mustafayildz/EE464-Term-Project-/PCB Output Documentation/3Dview.jpg

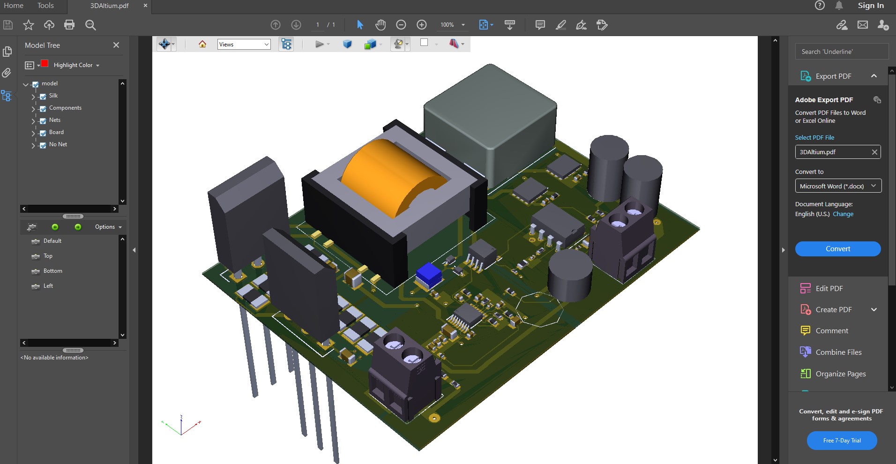
PCB Output Documentation/3Dview.jpg
