mustafayildz/EE464-Term-Project-/README.md

# EE464-Term-Project-
This repository is created by Mustafa Yıldız and Onur Öztaş for the EE464 Course Term Project
