mustafayildz/EE464-Term-Project-/Snubber Design.docx

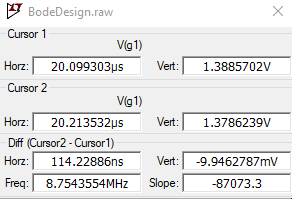
[picture p44: figure]
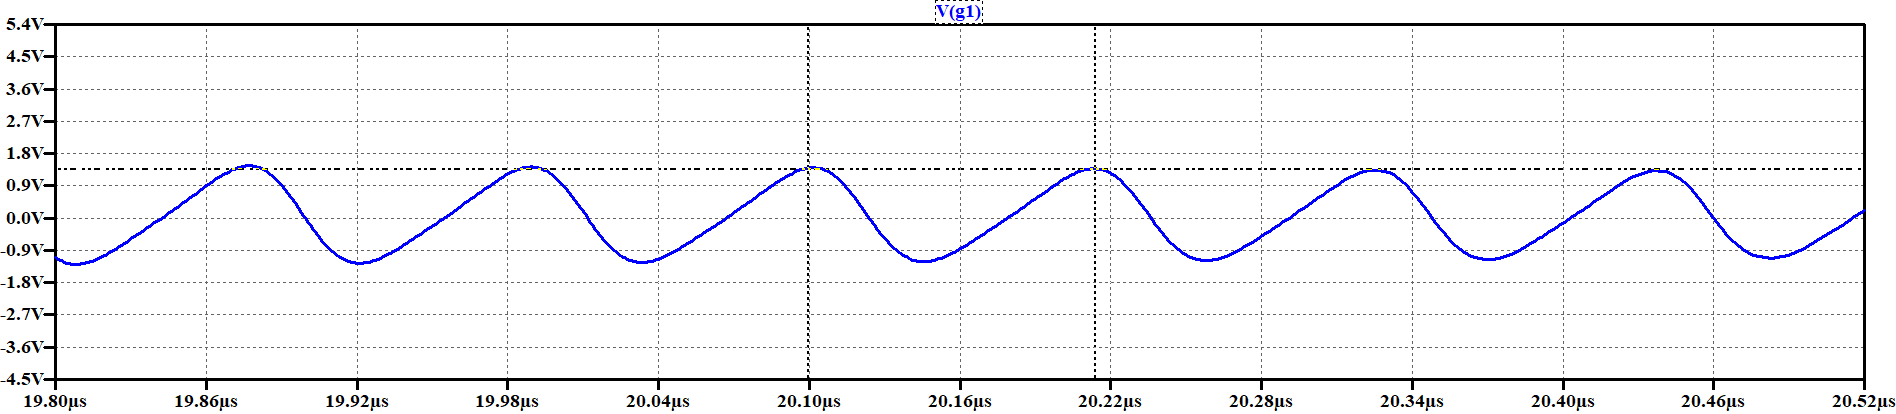
[picture p45: figure]

Resonant frequency is measured as 8.75 MHz Insert parallel capacitor to the MOSFET’s drain to source legs so that that frequency drops half of it. The value of the inserted capacitor is 1100 pF that reduces spike frequency by a factor of two. That capacitance is the three times the value of the parasitic capacitance that created voltage spikes.

C_p =1100/3 pF=367 pF (parasitic capacitance)

By using this value and the resonant frequency measured as above, the value of the parasitic inductance can be found as below.

L=1/((2*π*F_(res) )^2 *C_p)=1/((2*π*8.75*10^6 )^2 *367*10^(-12))=9*10^(-7) H

From these two found values, the characteristics impedance of the resonance can be found as below.

Z=√(L/C)=49.52 Ω

From the calculated impedance and capacitor values, the RC snubber circuits component values can be chosen as;

R≅Z≅49 Ω

4*C_p <C<10*C_p

1468 pF<C<3670 pF

For diode, the same procedure applied to the MOSFET’s can be applied. First resonance frequency of the spike is measured. It is found as 224 MHz Then, by connecting shunt capacitor the value of the parasitic capacitance is found in which the resonance frequency is reduced by a factor of two. Finally, by using the capacitance and resonance frequency values, inductance and reactance values can be found. At the end, almost same of the reactance is selected as snubber resistance, and 200pF capacitance value is selected as the snubber capacitance.

f = 224Mhz

C = 100pF

C_p =100/3 pF=33pF

L=1.53*10^(-8) H

Z=21.53 ohm
