mustafayildz/EE464-Term-Project-/Onur/Magnetic_Design_EER.docx

Transformer Magnetic Design

We set 16 as transformer turns ratio. Maximum input voltage is 400V, input frequency is 100kHz, maximum output current is 8.33A. A core should be selected due to stated specifications. There is no need for energy storing so we decided to use 2 E shape ferrite cores. Firstly, we calculated the area product for required core

W_a A_c =(V_(pri) *I_(pri))/(2*k_(cu) *J_(rms) *B_(ac) *f)

W_a A_c =100/(2*0.6*6*10^6 *0.2*100000)*10^8

W_a A_c =0.0694 cm^4

We checked E shaped ferrite cores and chose 0R42513EC core since it has the smallest area product which is larger than our minimum criteria. Primary and secondary winding turn numbers are calculated as:

N_(pri) >(V_(in))/(4*B_(ac) *A_(core) *f)

N_(pri) >400/(4*0.2*51.8*10^(-6) *100000)

N_(pri) >96.53

N_(pri) =112 Turns

N_(sec) =(N_(pri))/16

N_(sec) =7 Turns

Magnetizing inductance of the transformer is calculated as:

L_m =A_L *N_(pri) ^2

L_m =1900*10^(-9) *128^2

L_m =23.834 mH

RMS values of output and input currents should be calculated in order to make a cable selection.

I_(sec,rms) =√(D*I_(out,ave)^2 +2D*((I_(out,ave))/2)^2)

I_(sec,rms) =√(0.4364*8.333+2*0.4364*8.333^2)

I_(sec,rms) =6.742 A

RMS value of primary side can be found from the turns ratio.

I_(pri,rms) =6.742/16

I_(pri,rms) =0.421 A

Required conductor areas can be found with rms values of the currents and predetermined current density.

A_(pri) =(I_(pri,rms))/(J_(rms))

A_(pri) =0.421/6

A_(pri) = 0.0702 mm^2

A_(sec) =(I_(sec,rms))/(J_(rms))

A_(sec) =6.742/6

A_(sec) = 1.124 mm^2

For secondary side AWG16 satisfies the cross-sectional area but it fails with the frequency, it will work with full skin depth causing large losses. As we include the effect of skin depth, we should use AWG26 according to its maximum frequency for 100% skin depth. AWG26 has a smaller skin depth, so we have to parallel them for the secondary.

N_(parallel,pri) >(A_(pri))/(A_(AWG26))

N_(parallel,pri) >0.0702/0.128

N_(parallel,pri) = 1

N_(parallel,sec) =(A_(sec))/(A_(AWG26))

N_(parallel,sec) >1.124/0.128

N_(parallel,sec) = 10

A_(window) =M*2D

A_(window) =5.35*2*8.7

A_(window) =93.09mm^2

k_(cu) =(2*A_(copper,pri) +2*A_(copper,sec))/(A_(window))

k_(cu) =(2*112*0.128+2*7*10*0.128)/93.09

k_(cu) =50.1%

The design of transformer is completed. Fill factor is satisfactory. Losses of this transformer should be calculated. Copper losses are calculated as follows.

MLT=2п(E-F)/2

MLT=2п(17.5-7.5)/2

MLT=31.416 mm

R_(pri) =(N_p *MLT*R)/(Number of parallel cables)

R_(pri) =(112*31.416*133.8568*10^(-6))/1

R_(pri) =471 mΩ

R_(sec) =(N_p *MLT*R)/(Number of parallel cables)

R_(sec) =(7*31.416*133.8568*10^(-6))/10

R_(pri) =2.944 mΩ

P_(cu,total) =2*P_(cu,pri) +2*P_(cu,sec)

P_(cu,total) =2*0.421^2 *471*10^(-3) +2*8.333^2 *2.994*10^(-3)

P_(cu,total) =0.58W

Core loss is calculated as follows.

P_(core) =a*f^x *B^y *V_(core)

P_(core) =0.036*100^1.64 *0.2^2.68 *(2*2.99)

P_(core) =2.63 W

P_(transformer) =0.58+2.63

P_(transformer) =3.21 W

The related skin depth analysis for this application can be conducted as:

Skin Depth(δ)=√(ρ/(π*f_o *μ_r *μ_0))

δ=√(0.0171/(π*100*10^3 *0.999994*4*π*10^(-7)))

δ=208μm

In this design only AWG26 cable is used. Diameter of this cable is 0.403mm. Therefore, the skin depth exist which is 0.208mm will not create a problem for this design.

Inductor Magnetic Design

An output inductor is needed with capability of handling 8.33A and being larger than 160μH. We checked the cores from the smallest one in order to reduce costs and achieved our criterion at 0W41305TC. Calculations are as follows:

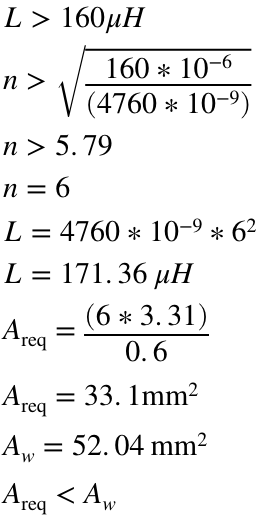
[picture p46: figure]
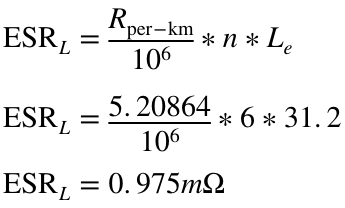
[picture p47: figure]
