mustafayildz/EE464-Term-Project-/EE464_Proje_Sunu.pptx

## EE 464 Term Project DC-DC Converter Design

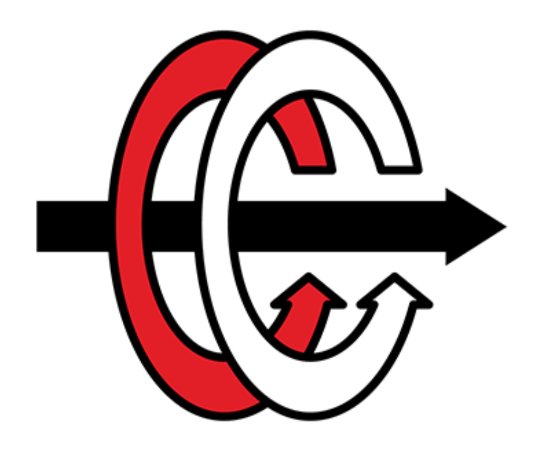
[picture p50: figure]
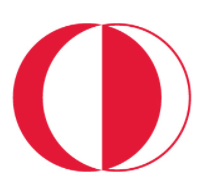
[picture p51: figure]
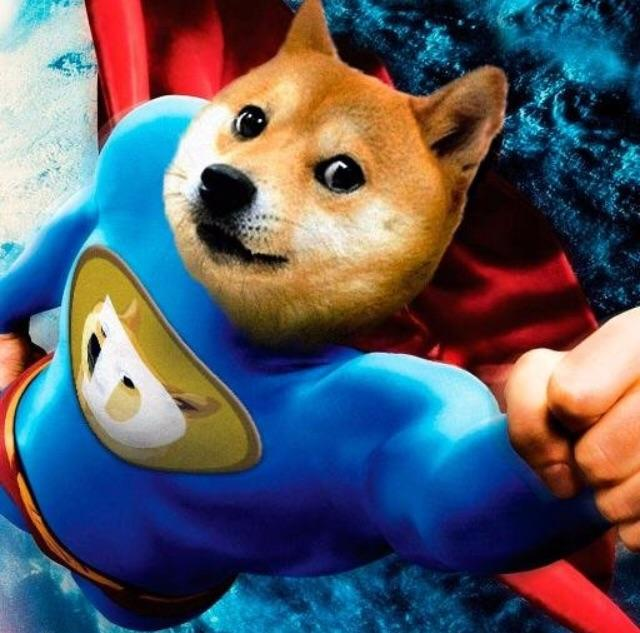
[picture p52: figure]
Doge power 🚀🌚🐕 : dogecoin

Doge Power Inc.
Onur Öztaş 2330389
Mustafa Yıldız 2233013

## Project Specifications

DC/DC
Converter

- 12V DC output voltage
- Isolated signal
- 100W output power
- Less than 4% voltage ripple
- Less than 3% line regulation
- Less than 3% load regulation

220V-400V DC Voltage

## Topology Selection

- Flyback
- Forward
- Half Bridge
- Full Bridge
- Push – Pull

## Topology Selection

- Flyback
Advantages:
- Less component requirement, no output inductance
Disadvantages:
- Big output capacitor requirement
- Narrow closed loop bandwidth

## Topology Selection

- Forward
Advantages:
- One switching element
Disadvantages:
- Transformer utilization factor is not sufficient

## Topology Selection

- Half Bridge
- Full Bridge

## Topology Selection

- Push Pull
Advantages:
- Better transformer utilization
  - Core size is small compared to others
  - Transformer ratings are smaller
- Small output filter requirement
Disadvantages:
- Center Tap Transformer configuration

## Analytical Calculations

V_o =V_(in) ∗2∗(N_2)/(N_1)∗D_(min)
12=400∗2∗1/16∗D_(min)
D_(min) =0.24
12=400∗2∗1/16∗D_(max)
D_(max) =0.4364

0.6/2=0.3
(220+400)/2=310
V_o =V_(in) ∗2∗(N_2)/(N_1)∗D
12=310∗2∗(N_2)/(N_1)∗0.3
(N_2)/(N_1)=1/16

- Calculation of Turns Ratio

- Limit Values of Duty Cycle

## Analytical Calculations

- Calculation of main parameters

(ΔV_o)/(V_o)=((1−2∗D)(1/(f_s))^2)/(8∗L∗C)
D=0.4364 (Worst Case)
0.04>((1−2∗0.4364)(1/(2∗f_s))^2)/(8∗L∗C)
L∗C∗f_s ^2 >0.09943

- f=100kHz

L∗C>0.09943/((10∗10^3 )^2)
L∗C>9.943∗10^(−12)

L=160μH

C>(9.943∗10^(−12))/(160∗10^(−6))
C>62.15 nF

## Output Filter Design

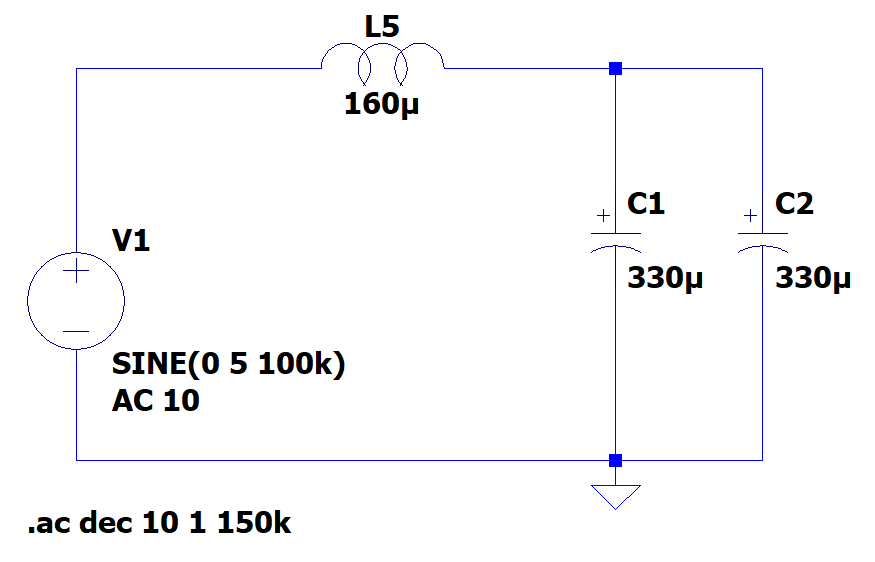
[picture p53: figure]
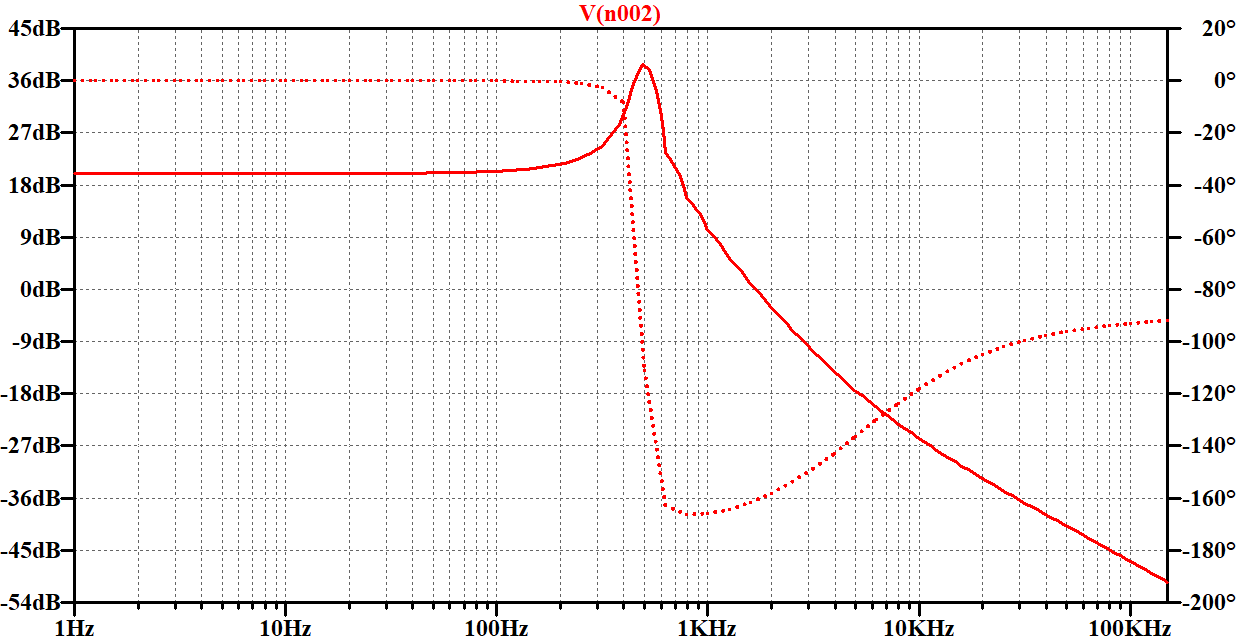
[picture p54: figure]

## Analytical Calculations

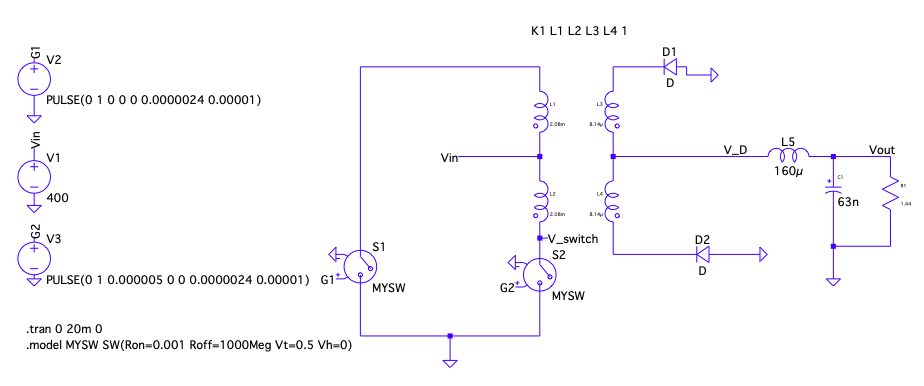
[picture p55: figure]

## Analytical Calculations

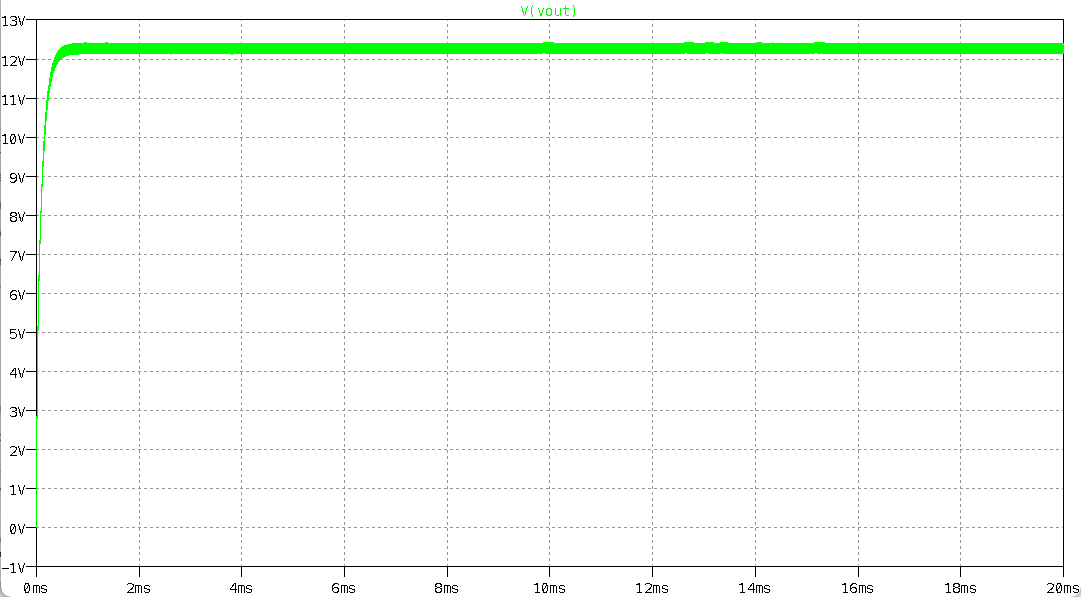
[picture p56: figure]
tablo içeren bir resim Açıklama otomatik olarak oluşturuldu

## Analytical Calculations

- Current Rating of Diodes
  - 9 A (forward)
- Voltage Rating of Switches
  - 800 V (blocking)
- Current Rating of Switches
  - 800 mA

- Current Rating of Output Inductor
  - 8.333 A
- Voltage Rating of Output Capacitor
  - 12 V
- Voltage Rating of Diodes
  - 50 V (blocking)

## Controller Design

LTC3723 Current Mode Controller

LT1431 Programmable Reference
(Opto – Driver )

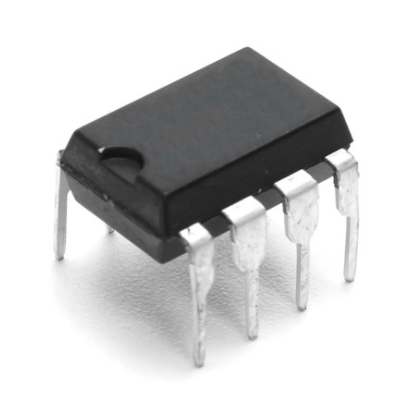
[picture p57: figure]
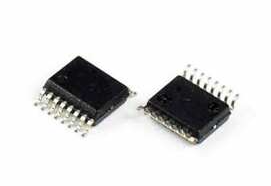
[picture p58: figure]
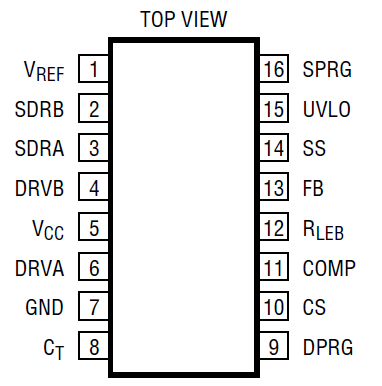
[picture p59: figure]
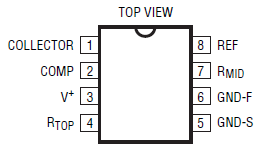
[picture p60: figure]

## Controller Compensator Design

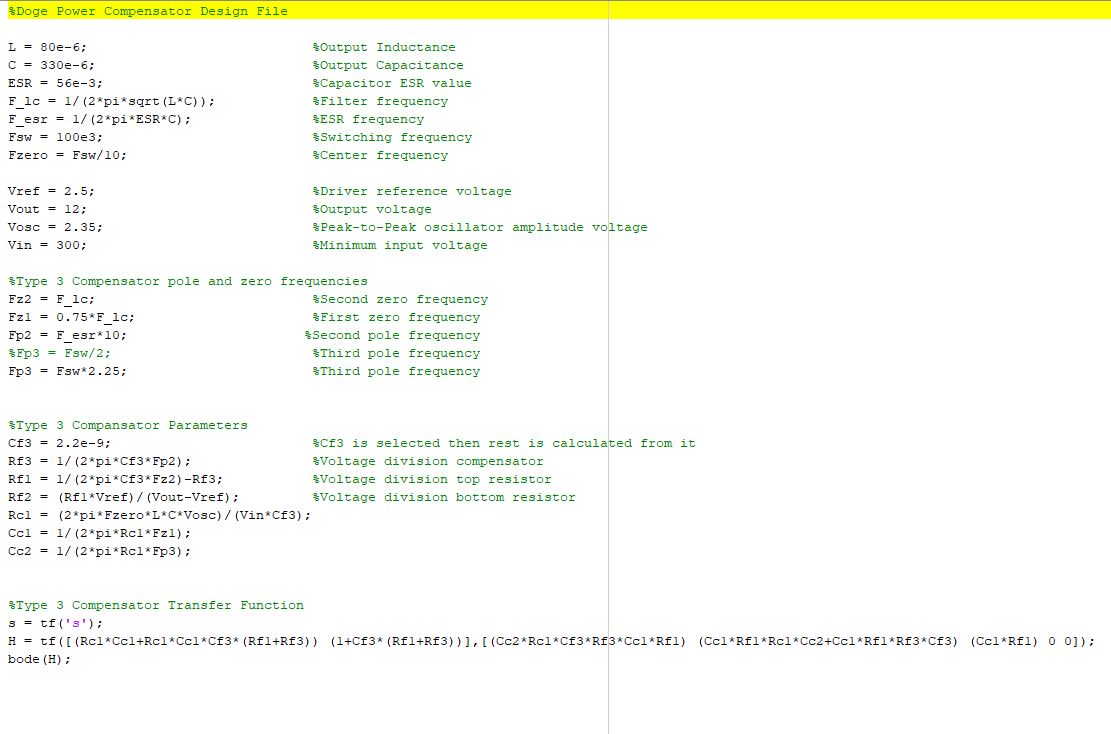
[picture p61: figure]

## Controller Compensator Design

## Controller Compensator Design

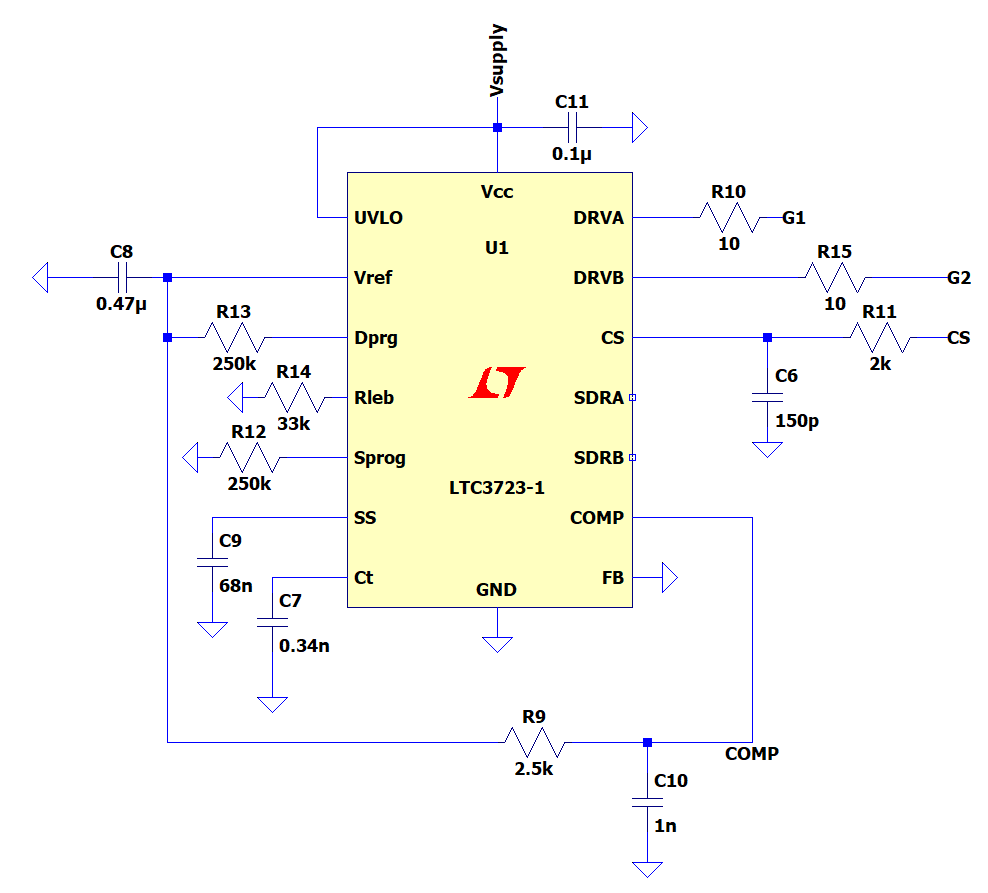
[picture p62: figure]

## Controller Compensator Design

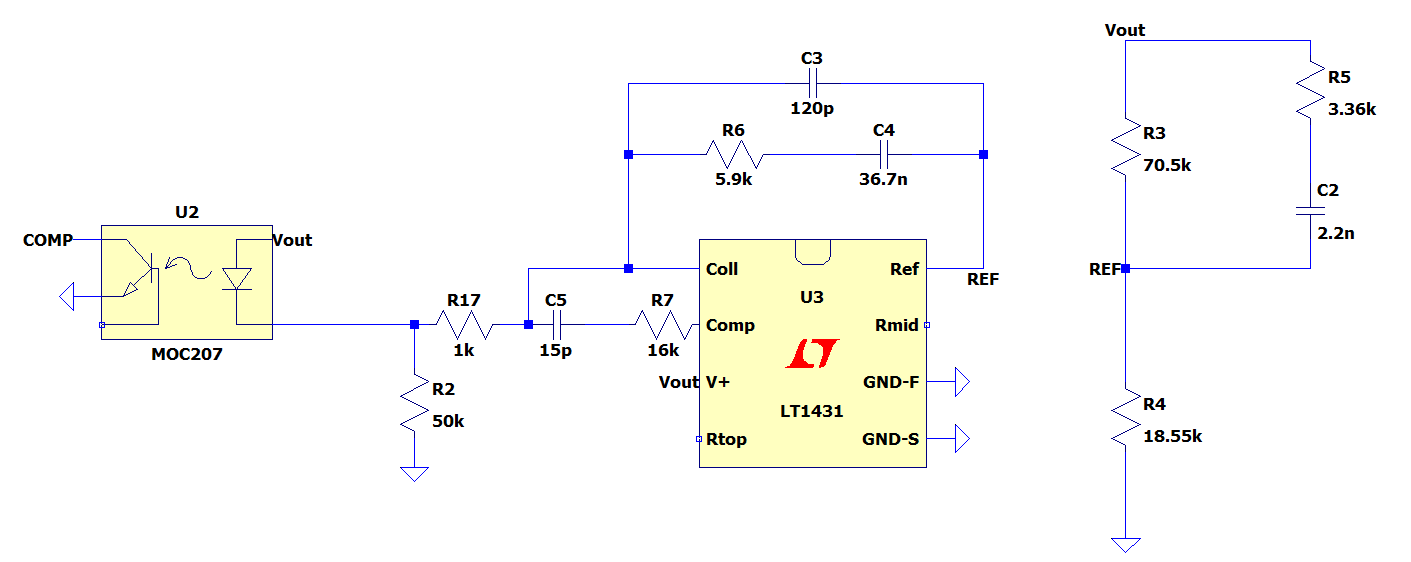
[picture p63: figure]

## Snubber Design


- Oscillation frequency : 8.75 MHz
  - C = 1100pF ; C_p =C/3 → L=1/((2∗π∗f_(osc) )^2 ∗C_p) →Z=√(L/C)
- R≅Z
- 4∗C_p <C<10∗C_p

## Snubber Design

## Simulation Results

- 220V input voltage

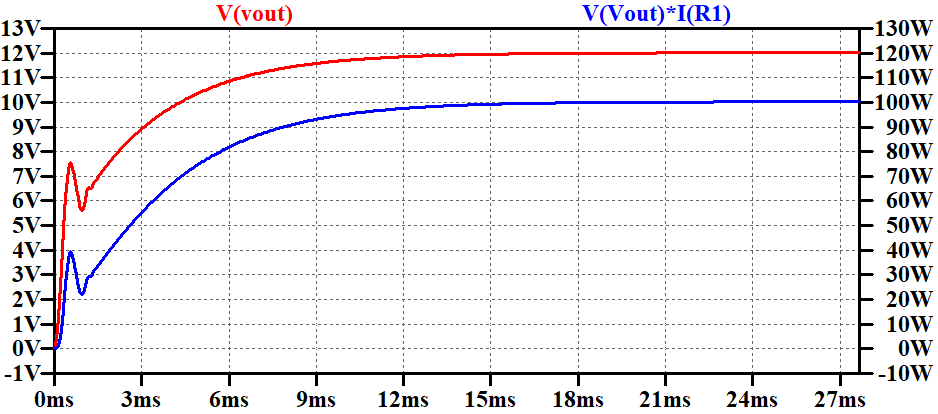
[picture p64: figure]

## Simulation Results

- 220V input voltage – output voltage ripple

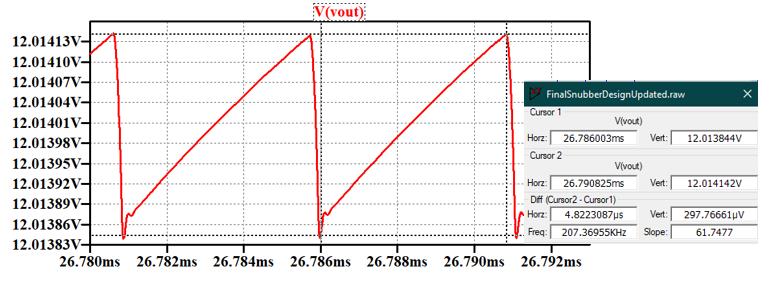
[picture p65: figure]

## Simulation Results

- 220V input, No load to Full Load


## Simulation Results

- 400V input voltage

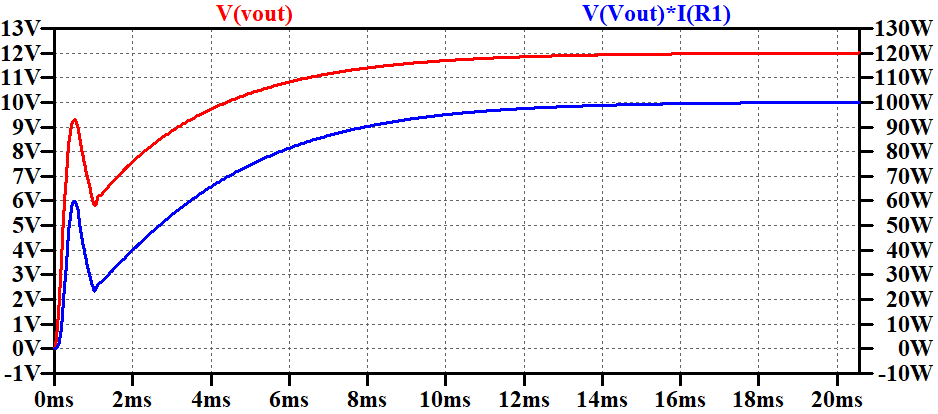
[picture p66: figure]

## Simulation Results

- 400V input voltage – output voltage ripple

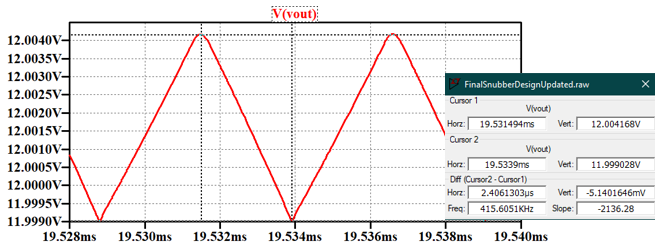
[picture p67: figure]

## Simulation Results

- 400V input, No load to Full Load

tablo içeren bir resim Açıklama otomatik olarak oluşturuldu

## Magnetic Design of Transformer

n_1 >(V_(i,max) ∗D_(max) ∗1/(f_s))/(B_(sat) ∗A_e)
n_1 >(400∗0.4364∗1/(100∗10^(−3)))/(0.53∗0.77∗10^(−6))
n_i >42.76
n_1 =48 Turns
n_2 =48/16
n_2 =3 Turns

- Minimum turns for not saturating the core

- Other Specifications

- Input Current
  - 0.25A at 100kHz
  - AWG 25 (due to frequency)
- Output Current
  - 9A DC
  - AWG 12 (due to current)
- 2 EER cores
  - PC47EER28-Z

## Magnetic Design of Transformer – Magnetising Inductance

µ=µ_0 ∗µ_r
µ=2500∗4∗π∗10^(−7)
µ=0.003142
R=((14+9.65)/2∗10^(−3) ∗2)/(µ∗(9.9/2)^2 ∗π)∗(((21.2+3.4)/2∗10^(−3) ∗2)/(µ∗4.35∗10^(−3) ∗11.4∗10^(−3))+((14+9.65)/2∗10^(−3) ∗2)/(µ∗3.4∗10^(−3) ∗11.4∗10^(−3)))/2
R=443821
L_m =(N^2)/R
L_m =(48^2)/443821
L_m =5.19 mH

## Magnetic Design of Transformer - Skin Depth

Skin Depth(δ)=√(ρ/(π∗f_o ∗μ_r ∗μ_0))
Skin Depth(δ)=√((1.678∗10^(−6))/(π∗100∗10^3 ∗0.999995∗4∗π∗10^(−7)))
Skin Depth(δ)= 206μm
AWG12 : 2.05mm diameter
AWG25 : 0.455mm diameter

## Magnetic Design of Inductor

L>160 µH
n>√((160∗10^(−6))/(4760∗10^(−9)))
n>5.79
n=6
L=4760∗10^(−9) ∗6^2
L=171.36 µH

- Selected Core: 0W41305TC

- ESR Value

ESR_L =(R_(per−km))/(10^6)∗n∗l_e
ESR_L =5.20864/(10^6)∗6∗(π∗5.08)
ESR_L =0.499mΩ

Filling Ratio = 0.6

A_(req) =(6∗3.31)/0.6
A_(req) =33.1 mm^2
A_w =52.04 mm^2

## Component Selection

- Key parts are:
  - Controllers
  - MOSFETs
  - Diodes
  - Thermal Analysis and Heatsink

## Component Selection

- MOSFET

- Drain-Source Resistance
  - 350m Ω
- Transient time
  - Rise time: 16 ns
  - Fall time: 17 ns
- Gate Charge
  - 19 nC

- Diodes

- Forward voltage
  - 0.56 V

## Component Selection - Controllers

- LTC3723-1

- Controller + Gate Driver
- Non-isolated – Required external isolation
- Dead-Time control
- Frequency control
- Soft start property
- 2 gate synchronous drive capability

- LT1431

- Opto-coupler driver
- Internal compensator design property

## Loss Calculations

MOSFETs (Calculated for One):
P_(conduction) =I^2 ∗D∗R_(DS)
P_(conduction) =7^2 ∗0.12∗0.35
P_(conduction) =2.058 W
P_(switching) =1/2∗V_(in) ∗I_(in) ∗(t_r +t_f )∗f
P_(switching) =1/2∗400∗7∗(16+17)∗10^(−9) ∗100∗10^3
P_(switching) =4.62 W
P_(gate) =V_(GS) ∗f∗Q_g
P_(gate) =20∗100∗10^3 ∗19∗10^(−9)
P_(gate) =0.038 W

## Loss Calculations

Transformer:
P_(core) =1.72 W
Diodes (Calculated for One):
P_(loss) =0.6∗I_(f(AV)) +0.00367∗I_(f(rms))^2
P_(loss) =0.6∗4.165 +0.00367∗5.592^2
P_(loss) =2.613 W
Output Inductor:
P_(loss) =I_o^2 ∗ESR
P_(loss) =8.333^2 ∗0.499∗10^(−3)
P_(loss) =0.035 W
Integrated Circuits:
P_(total) =0.42 W

## Thermal Analysis - MOSFET

P_(loss,MOSFET) =6.716 W

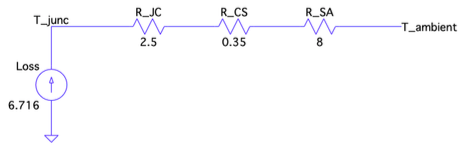
[picture p68: figure]

T_(junction) =(8+0.35+2.5)∗6.716+25
T_(junction) =97.87^o C
