mustafayildz/EE464-Term-Project-/Mustafa/Closed Loop Design/400Vin_Output_Voltage_Ripple.png

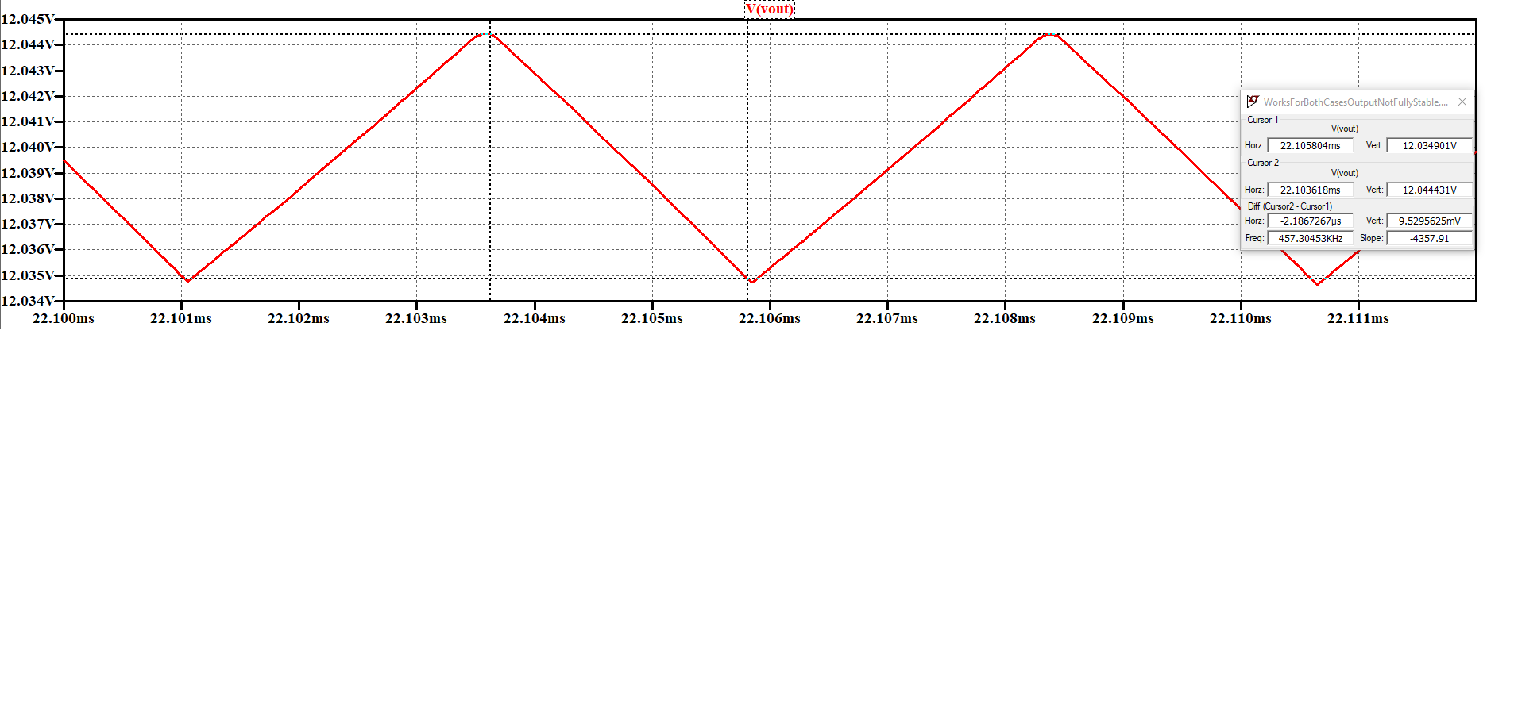
Mustafa/Closed Loop Design/400Vin_Output_Voltage_Ripple.png
