mustafayildz/EE464-Term-Project-/Mustafa/Closed Loop Design/NoLoad_to_Full_Load_220V.png

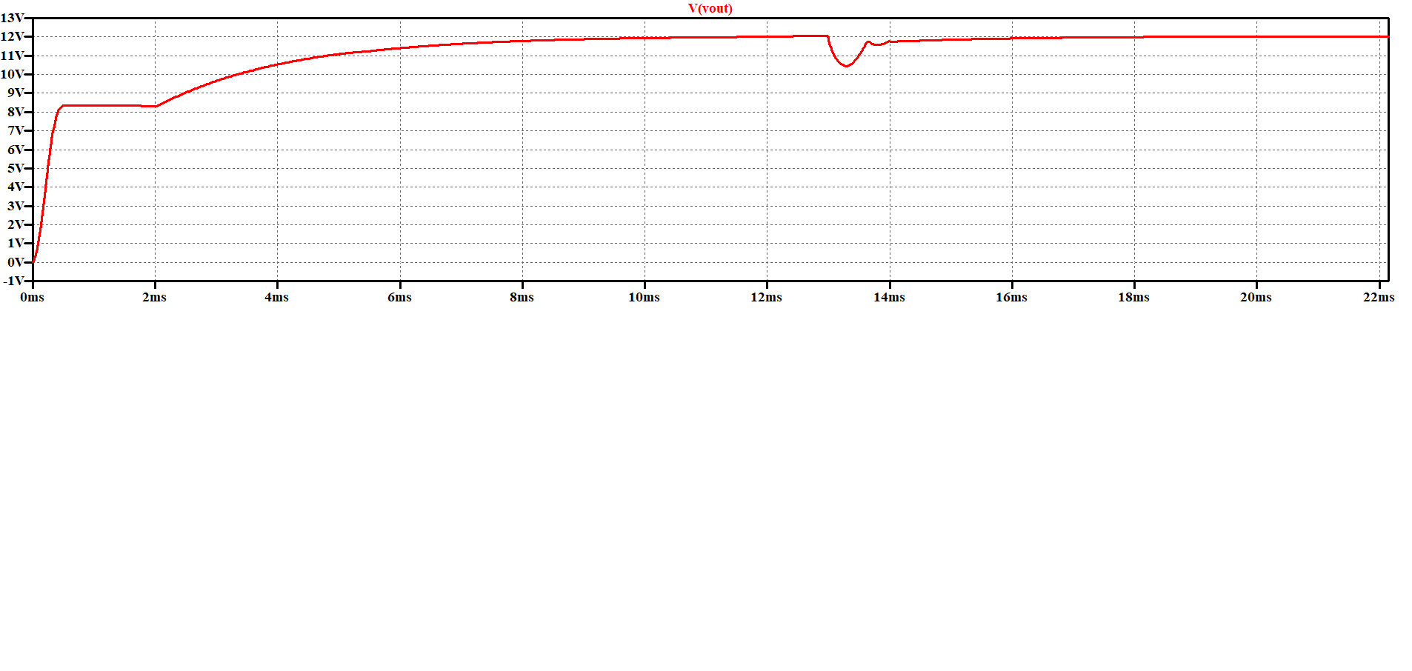
Mustafa/Closed Loop Design/NoLoad_to_Full_Load_220V.png
