mustafayildz/EE464-Term-Project-/Mustafa/Closed Loop Design/NoLoad_to_Full_Load_400V.png

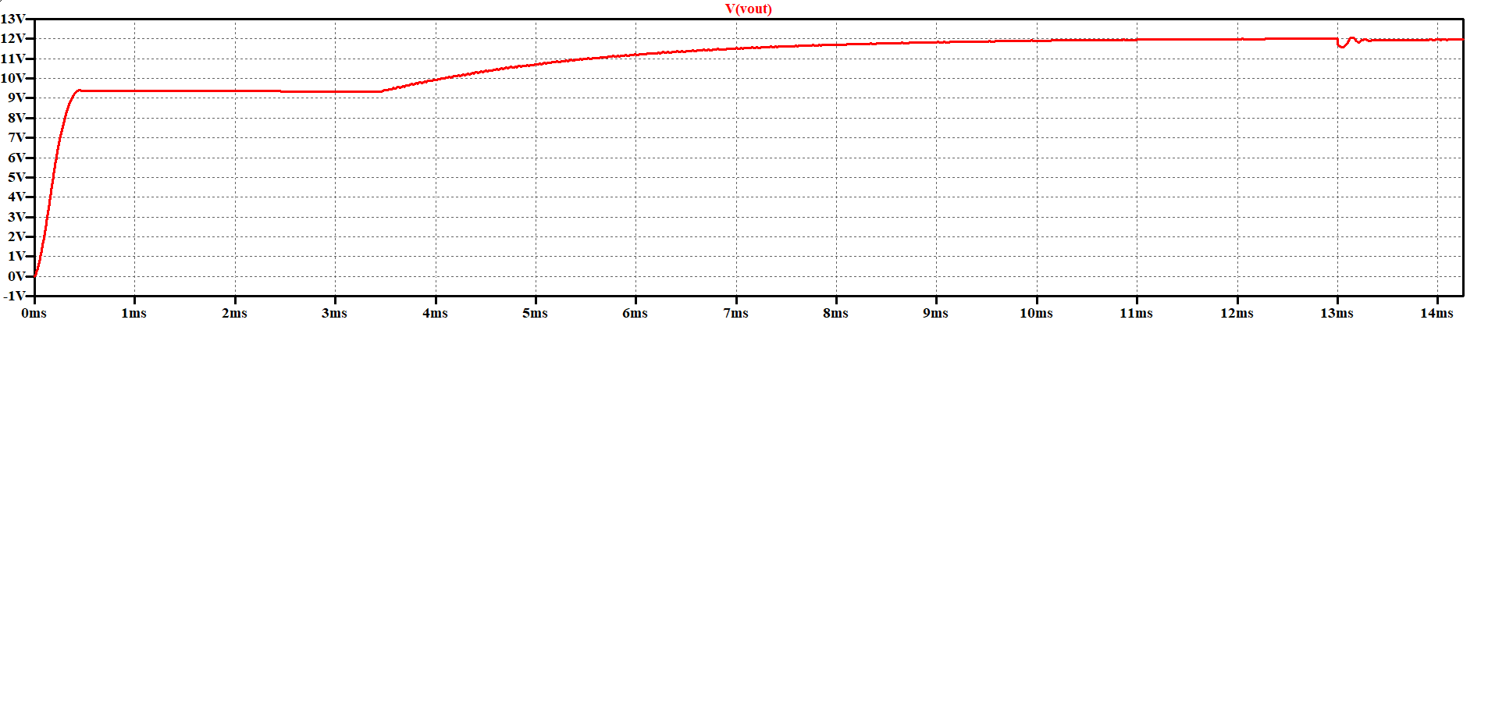
Mustafa/Closed Loop Design/NoLoad_to_Full_Load_400V.png
