mustafayildz/EE464-Term-Project-/Onur/BOM.xlsx

Component | Serial Number | Price($) (unit price for purchase of 1000) | ESR | ESL | Vf
Controller | LTC3723EGN-1#PBF | 6.48
C8 | MA0805XR474K500 | 0.0095
C9 | GMC04X5R683K16NT | 0.0038
C7 | MA0402XR331K500 | 0.00262
C10 | GMC02X7R102M16NT | 0.0019
C6 | GMC04X7R151K16NT | 0.0032
C1 | 337CKS025M | 0.10051 | 0.703 Ohm
C2 | GMC04X7R222K50NT | 0.0028
C3 | GMC04CG120J25NT | 0.0018
C4 | GMC04X7R393K25NT | 0.0048
C5 | GMC04CG150J50NT | 0.0019
C12 | GMC21CG201J100NT | 0.027
C13 | GMC21CG201J100NT | 0.027
C14 | 90150 | 0.1532
C16 | 90150 | 0.1532
C17 | 337CKS025M | 0.10051 | 0.703 Ohm
Transformer Core | PC47EER28L-Z | 0.9576
D1 | STPS30H100DJF-TR | 0.4914 |  |  | 0.56
D2 | STPS30H100DJF-TR | 0.4914 |  |  | 0.56
Optoisolator | MOC207M | 0.25
Voltage Reference | LT1431CS8#TRPBF | 2.58
C11 | MC04X5R104K25NT | 0.0045
Output Inductor Core | 0W41305TC | 2
M1 | C3M0350120D | 3.5
M2 | C3M0350120D | 3.5
Heatsink 1 | 513301B02500G | 0.83992
Heatsink 2 | 513301B02500G | 0.83992
Thermal Pad | Q3-0.005-00-114 | 0.05
Thermal Pad | Q3-0.005-00-114 | 0.05
Total |  | 22.62848
