mustafayildz/EE464-Term-Project-/PCB Output Documentation/PCB_Project_1.xlsx

Comment | Description | Designator | Quantity | Mouser2 Price/Stock | Mouser Price/Stock
C0603C151G1GACTU | Capacitor | 2C150p | 1 |  | https://www.mouser.co.uk/ProductDetail/KEMET/C0603C151G1GACTU?qs=tVefkKa6a1jhbIoxyvPmcA%3D%3D
06031C104K4Z2A | Capacitor | C0.1u | 1 |  | https://www.mouser.co.uk/ProductDetail/AVX/06031C104K4Z2A?qs=rI7uf1IzohSnOGTrilMFWw%3D%3D
04025C102JAT2A | Capacitor | C1n | 1 |  | https://www.mouser.co.uk/ProductDetail/AVX/04025C102JAT2A?qs=A%252BjgVRj0cIhSqwAr58%2FhLg%3D%3D
C1608X5R1H105K080AB | Capacitor | C1u | 1 |  | https://www.mouser.co.uk/ProductDetail/TDK/C1608X5R1H105K080AB?qs=NRhsANhppD%252BLmxnPDqAv3A%3D%3D
CL31A106MBHNNNE | Capacitor | C10u | 1 |  | https://www.mouser.co.uk/ProductDetail/Samsung-Electro-Mechanics/CL31A106MBHNNNE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
06035A220JAT2A | Capacitor | C22p | 1 |  | https://www.mouser.co.uk/ProductDetail/AVX/06035A220JAT2A?qs=WmCxkUxNecRe2%252BrYSa2zPg%3D%3D
885012206070 | Capacitor | C68n | 1 |  | https://www.mouser.co.uk/ProductDetail/Wurth-Elektronik/885012206070?qs=0KOYDY2FL2%252BdYxnLFqlX4w%3D%3D
CL10C151JB8NNNC | Capacitor | C150p | 1 |  | https://www.mouser.co.uk/ProductDetail/Samsung-Electro-Mechanics/CL10C151JB8NNNC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
1206B471K102CT | Capacitor | C470p, C2470p | 2 |  | https://www.mouser.com/Search/Refine.aspx?Keyword=791-1206B471K102CT
CGA4J1X8L1H474K125AE | Capacitor | C.47u | 1 |  | https://www.mouser.co.uk/ProductDetail/TDK/CGA4J1X8L1H474K125AE?qs=zW32dvEIR3uIPrP%252BfC4jsA%3D%3D
CL10A226MP8NUNE | Capacitor | Caux | 1 |  | https://www.mouser.co.uk/ProductDetail/Samsung-Electro-Mechanics/CL10A226MP8NUNE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
GRM3195C2A363JA01D | Capacitor | Cbot | 1 |  | https://www.mouser.co.uk/ProductDetail/Murata-Electronics/GRM3195C2A363JA01D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
GRM21B5C2J222FWAAL | Capacitor | Ccomp | 1 |  | https://www.mouser.co.uk/ProductDetail/Murata-Electronics/GRM21B5C2J222FWAAL?qs=hd1VzrDQEGgwnUkpelVx4g%3D%3D
GCQ1555C1H150FB01D | Capacitor | Cmid | 1 |  | https://www.mouser.co.uk/ProductDetail/Murata-Electronics/GCQ1555C1H150FB01D?qs=0lQeLiL1qybEKEeEBMn8jw%3D%3D
ECA-1EM331BJ | Capacitor Polarised | Cout, Cout2 | 2 |  | https://www.mouser.co.uk/ProductDetail/Panasonic/ECA-1EM331BJ/?qs=QmEuDp8986QdrzUPtmlFjw%3D%3D
GRM1885C2A201JA01D | Capacitor | CsnubDio, CsnubDio? | 2
GRM1885C2A361JA01D | Capacitor | CT340p | 1
C0402C121K8RACTU | Capacitor | Ctop | 1 |  | https://www.mouser.co.uk/ProductDetail/KEMET/C0402C121K8RACTU/?qs=GedFDFLaBXGLzkg%252BSPpg%2FA%3D%3D
C1210C104KBRACAUTO | Capacitor | Ctransformer | 1 |  | https://www.mouser.co.uk/ProductDetail/KEMET/C1210C104KBRACAUTO?qs=LTU7o1cE%2FK70wT3jsEJwBA%3D%3D
NSR0170HT1G | Schottky Diode | Daux1, Daux2 | 2 |  | https://www.mouser.com/Search/Refine.aspx?Keyword=863-NSR0170HT1G
STPS30H100DJF-TR | Schottky Diode | DiodePush1, DiodePush2 | 2 |  | https://www.mouser.co.uk/ProductDetail/STMicroelectronics/STPS30H100DJF-TR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
COMPONENT_1_1 | Doge | DogeTransformer | 1
LT1431IN8#PBF | Integrated Circuit | IC1431 | 1 |  | https://www.mouser.com/Search/Refine.aspx?Keyword=584-LT1431IN8%23PBF
LTC3723EGN-1#PBF | Integrated Circuit | IC3723 | 1 |  | https://www.mouser.com/Search/Refine.aspx?Keyword=584-LTC3723EGN-1%23PBF
1716020000 | Connector | IN, Out | 2
SRP2313AA-680M | Inductor | L68u | 1
TYS4030101M-10 | Inductor | Laux | 1 |  | https://www.mouser.com/Search/Refine.aspx?Keyword=875-TYS4030101M-10
MOC207M | Integrated Circuit | Moc207 | 1 |  | https://www.mouser.co.uk/ProductDetail/ON-Semiconductor-Fairchild/MOC207M?qs=NkuxCoaTQKYYnjhPw1nang%3D%3D
STW11NK100Z | Integrated Circuit | Mosfet1, Mosfet2 | 2 |  | https://www.mouser.co.uk/ProductDetail/STMicroelectronics/STW11NK100Z?qs=wnz1wyZ0ZnXy8ArXh%2FwYmg%3D%3D
2N2219_PBFREE | Transistor BJT NPN | Qaux | 1 |  | https://www.mouser.co.uk/ProductDetail/Central-Semiconductor/2N2219-PBFREE?qs=l7cgNqFNU1hh5MQQmrw1mA%3D%3D
ERA-3VEB2001V | Resistor | R2k | 1 |  | https://www.mouser.co.uk/ProductDetail/Panasonic/ERA-3VEB2001V?qs=OlC7AqGiEDkV%2FLMQkd7vjg%3D%3D
ERA-3AED2491V | Resistor | R2K5 | 1 |  | https://www.mouser.co.uk/ProductDetail/Panasonic/ERA-3AED2491V?qs=MNPzkKEzRtTURs0mKAUGRQ%3D%3D
MCT06030C2493FP500 | Resistor | R250k, R_2_250k | 2 |  | https://www.mouser.com/Search/Refine.aspx?Keyword=594-MCT06030C2493FP5
RT0603BRD07464KL | Resistor | Raux1 | 1 |  | https://www.mouser.co.uk/ProductDetail/Yageo/RT0603BRD07464KL?qs=m9MW%2FJRFFS3yR3sDGxiA%2FQ%3D%3D
ERA-3APB273V | Resistor | Raux_2 | 1 |  | https://www.mouser.com/Search/Refine.aspx?Keyword=667-ERA-3APB273V
ERA-3VEB1502V | Resistor | RauxB | 1 |  | https://www.mouser.co.uk/ProductDetail/Panasonic/ERA-3VEB1502V?qs=OlC7AqGiEDkoKxA%252BvKCzUw%3D%3D
CPF0603B30RE | Resistor | RauxE | 1 |  | https://www.mouser.co.uk/ProductDetail/TE-Connectivity-Neohm/CPF0603B30RE?qs=gt1LBUVyoHlpGUuVLJ9HIg%3D%3D
Resistor 6K2 +/-5 % 0402 63 mW | Chip Resistor, 6,2 kOhms, +/-5 %, 63 mW, -55 to 155 degC, 0402 | Rbot | 1
CPF0603B3K32E | Resistor | Rcomp | 1 |  | https://www.mouser.co.uk/ProductDetail/TE-Connectivity-Neohm/CPF0603B3K32E?qs=s1WWODT2SXU5S6IP14mfOA%3D%3D
ERA-3AEB6982V | Resistor | Rd1 | 1 |  | https://www.mouser.co.uk/ProductDetail/Panasonic/ERA-3AEB6982V?qs=nuXzIS8loXG44F6SvdF0rQ%3D%3D
MCT06030D1802BP500 | Resistor | Rd2 | 1 |  | https://www.mouser.com/Search/Refine.aspx?Keyword=594-MCT06030D1802BP5
ERA-3AED333V | Resistor | Rleb33k | 1 |  | https://www.mouser.co.uk/ProductDetail/Panasonic/ERA-3AED333V?qs=yocZuyCaXdPx5xHP%2FbupFw%3D%3D
ERA-3ARB163V | Resistor | Rmid | 1 |  | https://www.mouser.co.uk/ProductDetail/Panasonic/ERA-3ARB163V/?qs=ob%252BdNz2%252BYEgOuIDPhzMhhA%3D%3D
1KR5J | 1K 0.125W 5% 0805 (2012 Metric) SMD | Rnext | 1
Resistor 51k +/-5% 0402 63 mW | Chip Resistor, 51 KOhm, +/- 5%, 0.063 W, -55 to 155 degC, 0402 (1005 Metric) | Rntg | 1
ERJ-2BSFR10X | Resistor | Rsense | 1 |  | https://www.mouser.co.uk/ProductDetail/Panasonic/ERJ-2BSFR10X?qs=0n%252BW%2FEG%252BKm7ed6yiU%2FeiUw%3D%3D
RC0603FR-1022RL | Resistor | RsnubDio, RsnubDio? | 2 |  | https://www.mouser.com/Search/Refine.aspx?Keyword=603-RC0603FR-1022RL
CRGH2512F221R | Resistor | Rsnubm1, Rsnubm2, Rsnubm3, Rsnubm4, Rsnubm5, Rsnubmos1, Rsnubmos2, Rsnubmos3, Rsnubmos4, Rsnubmos5 | 10 |  | https://www.mouser.com/Search/Refine.aspx?Keyword=279-CRGH2512F221R
