mustafayildz/EE464-Term-Project-/Onur/inductor.stp

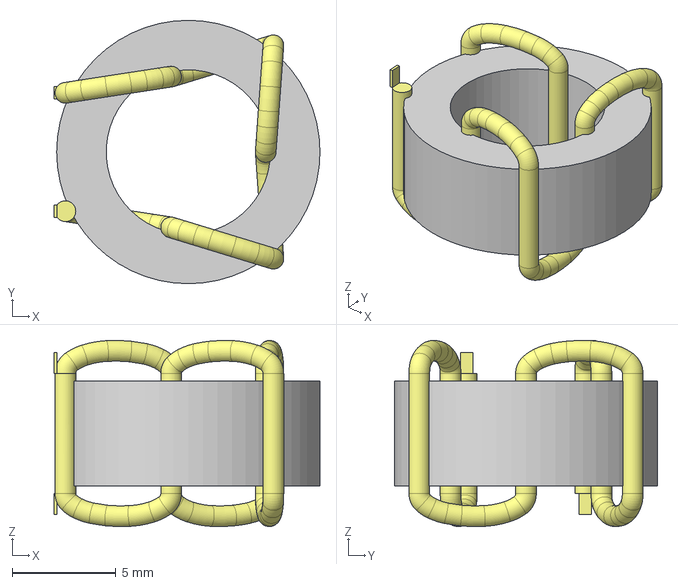
[picture p121: CAD file, 2021-06-23]
Onur/inductor.stp
12.8 x 12.7 x 8.98 mm
