mustafayildz/EE464-Term-Project-/Onur/transformator.stp

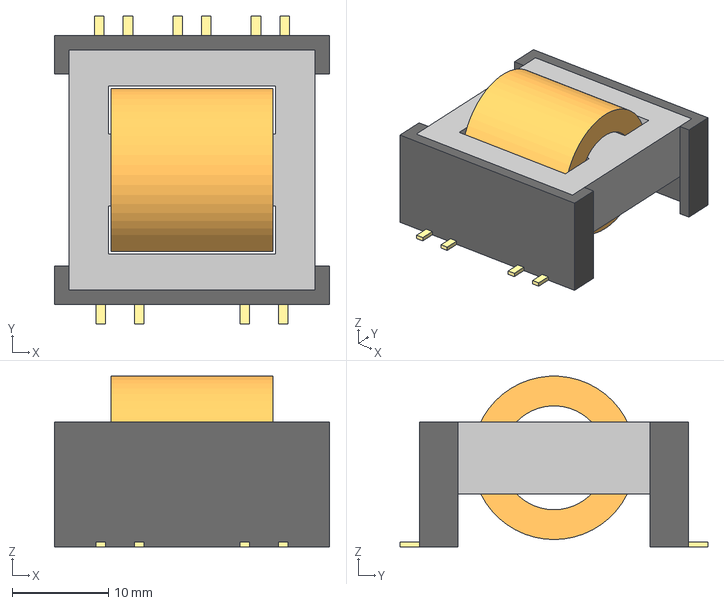
[picture p122: CAD file, 2021-06-15]
Onur/transformator.stp
28.6 x 32.0 x 17.7 mm
