mustafayildz/EE464-Term-Project-/Final Report Simulation Results/Plots.docx

V_IN = 220V

Vout


V_DS Signals


I_L


V_Primary vs V_secondary

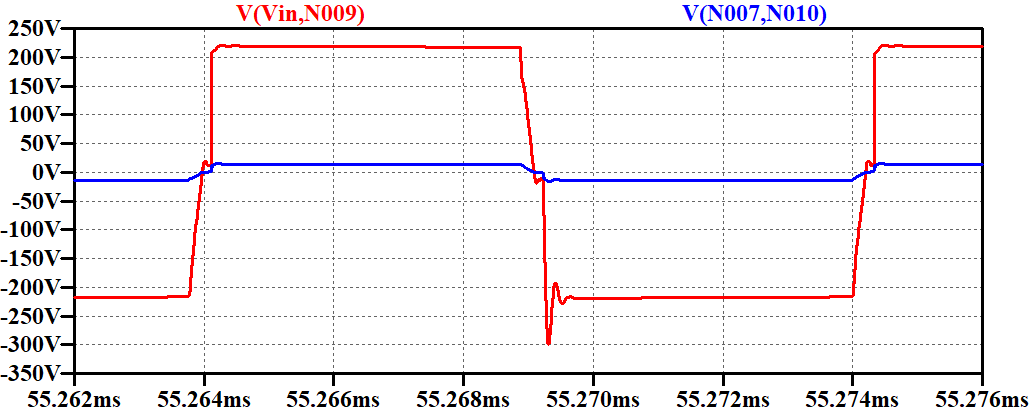
[picture p123: figure]

V_out & P_out


I_comp

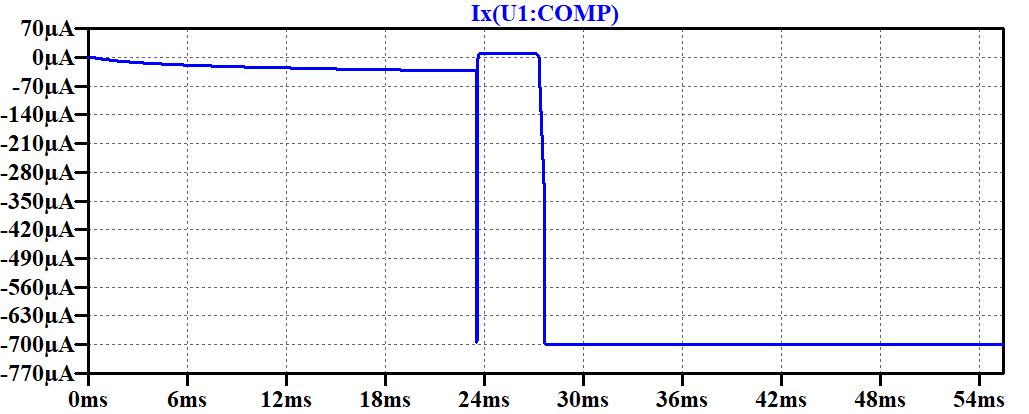
[picture p124: figure]

V_gates


V_IN = 400V

Vout


V_DS Signals

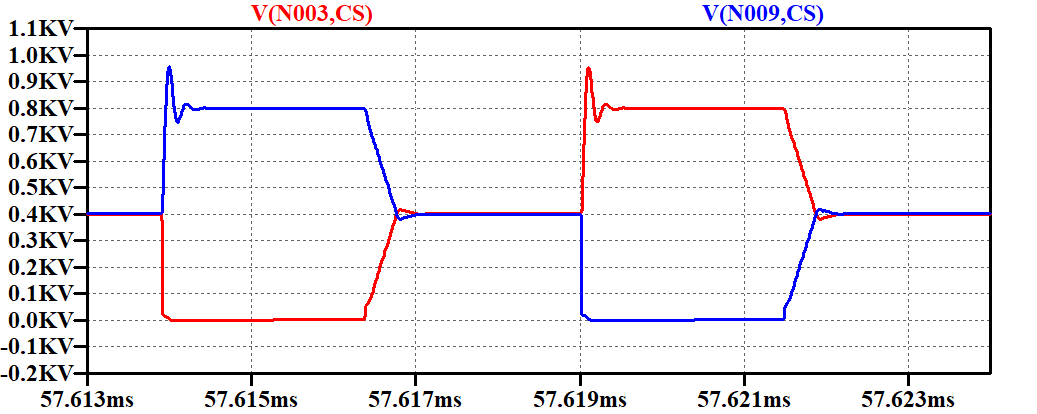
[picture p125: figure]

I_L


V_Primary vs V_secondary

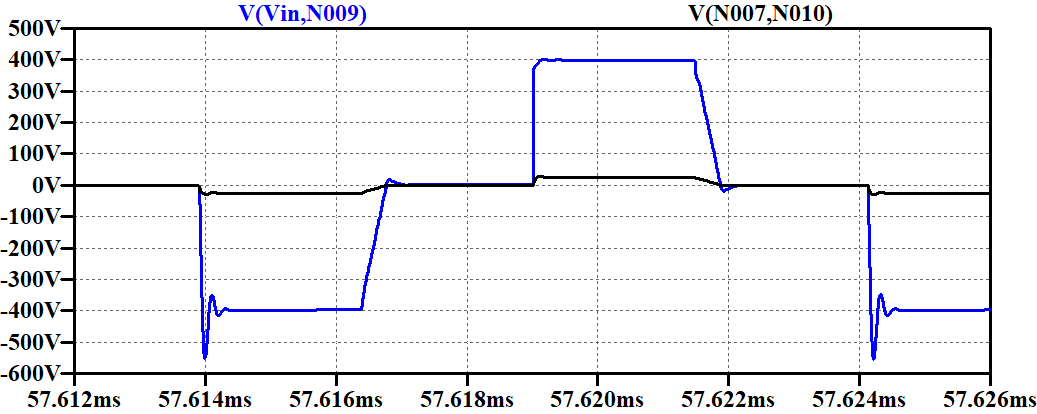
[picture p126: figure]

V_out & P_out


I_comp


V_gates
