mustafayildz/EE464-Term-Project-/Mustafa/220Vin_Closed_Loop_Sim_Results.png

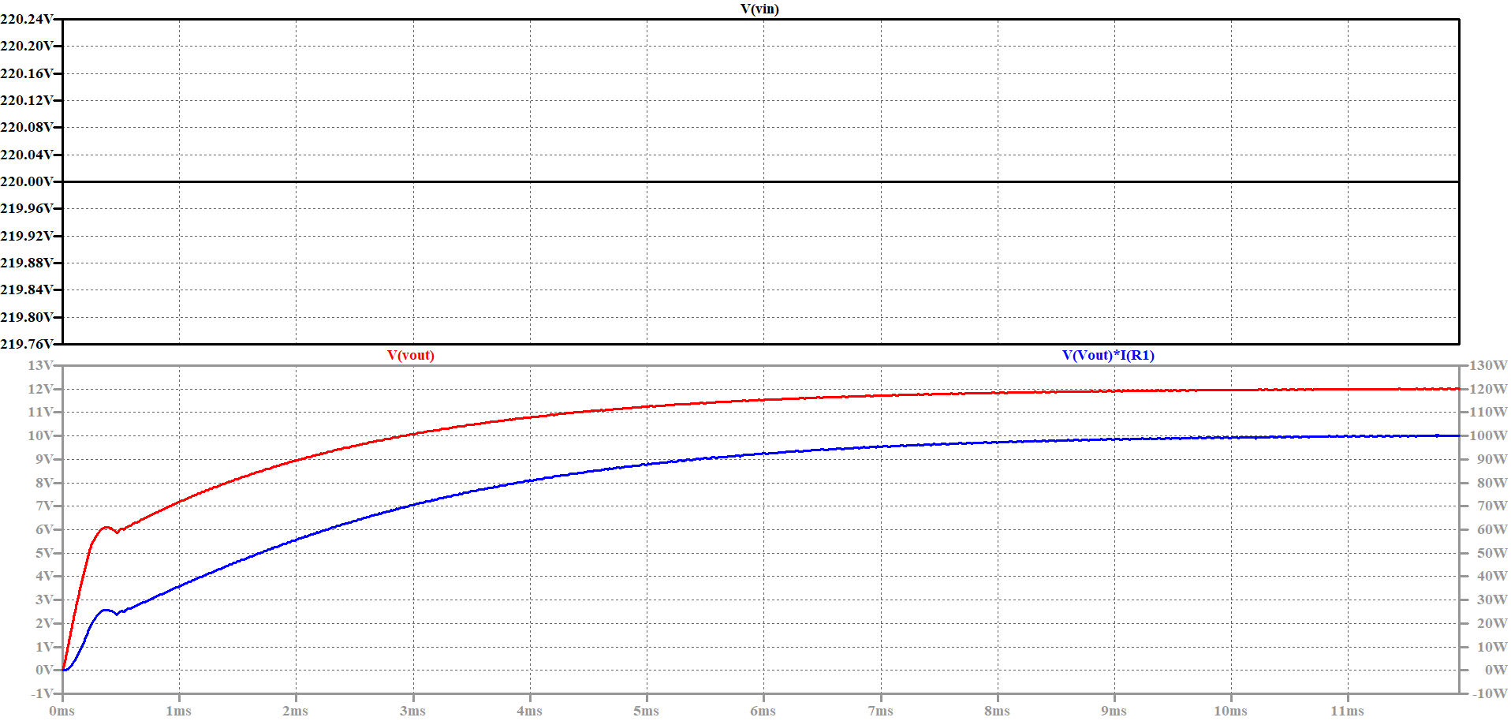
Mustafa/220Vin_Closed_Loop_Sim_Results.png
