mustafayildz/EE464-Term-Project-/Mustafa/400Vin_Closed_Loop_Sim_Results.png

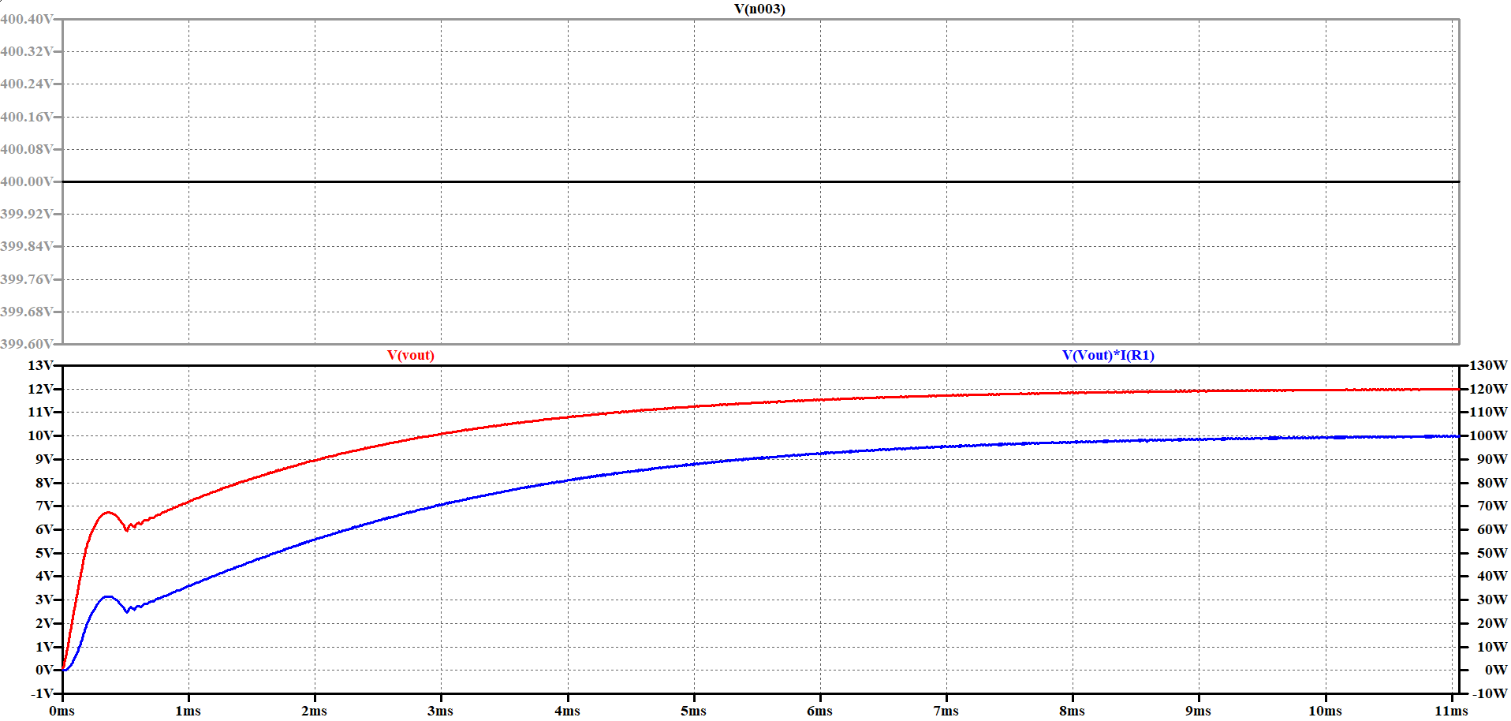
Mustafa/400Vin_Closed_Loop_Sim_Results.png
