mustafayildz/EE464-Term-Project-/Mustafa/Open Loop Design/Simulation Results/Output Filter AC Analysis.png

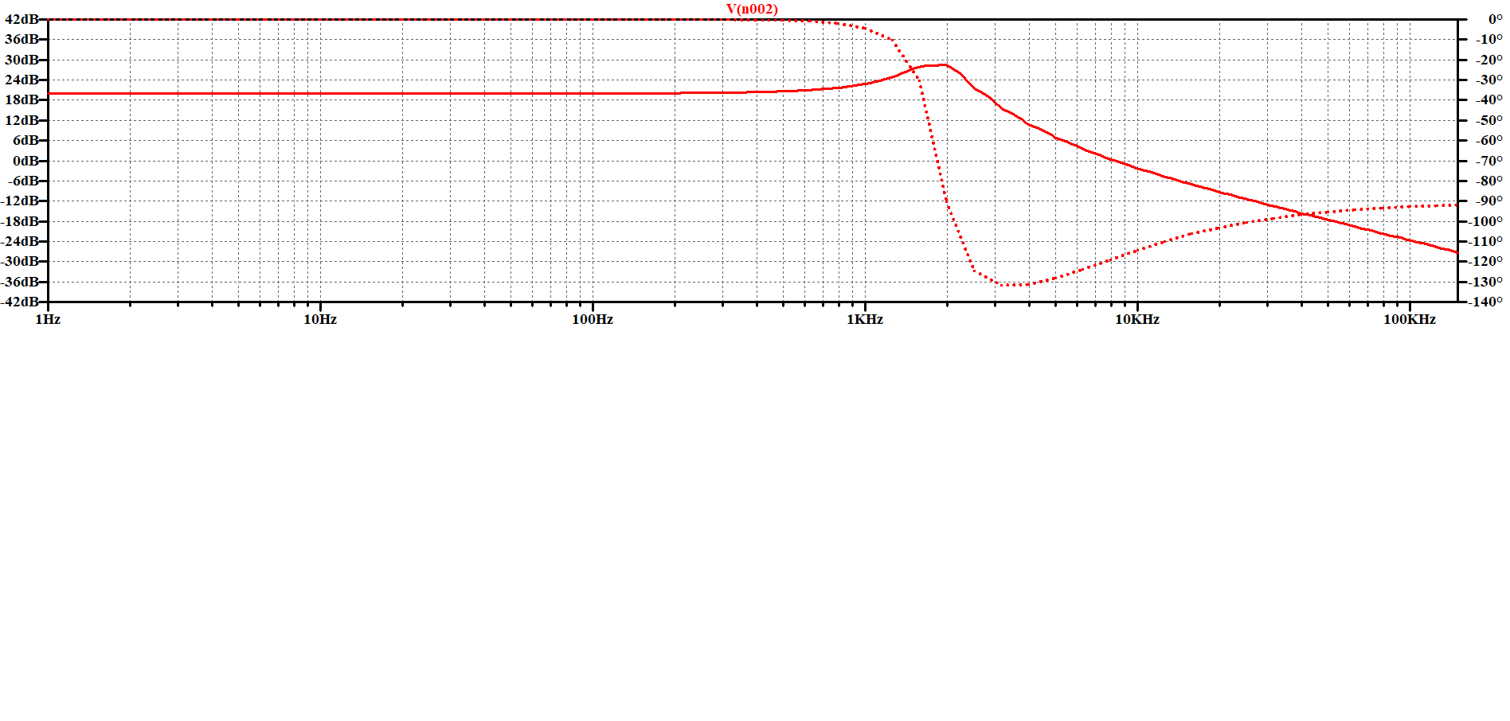
Mustafa/Open Loop Design/Simulation Results/Output Filter AC Analysis.png
