mustafayildz/EE464-Term-Project-/Mustafa/Open Loop Design/Simulation Results/Output Voltage and Power waveforms when Vin is 220V.png

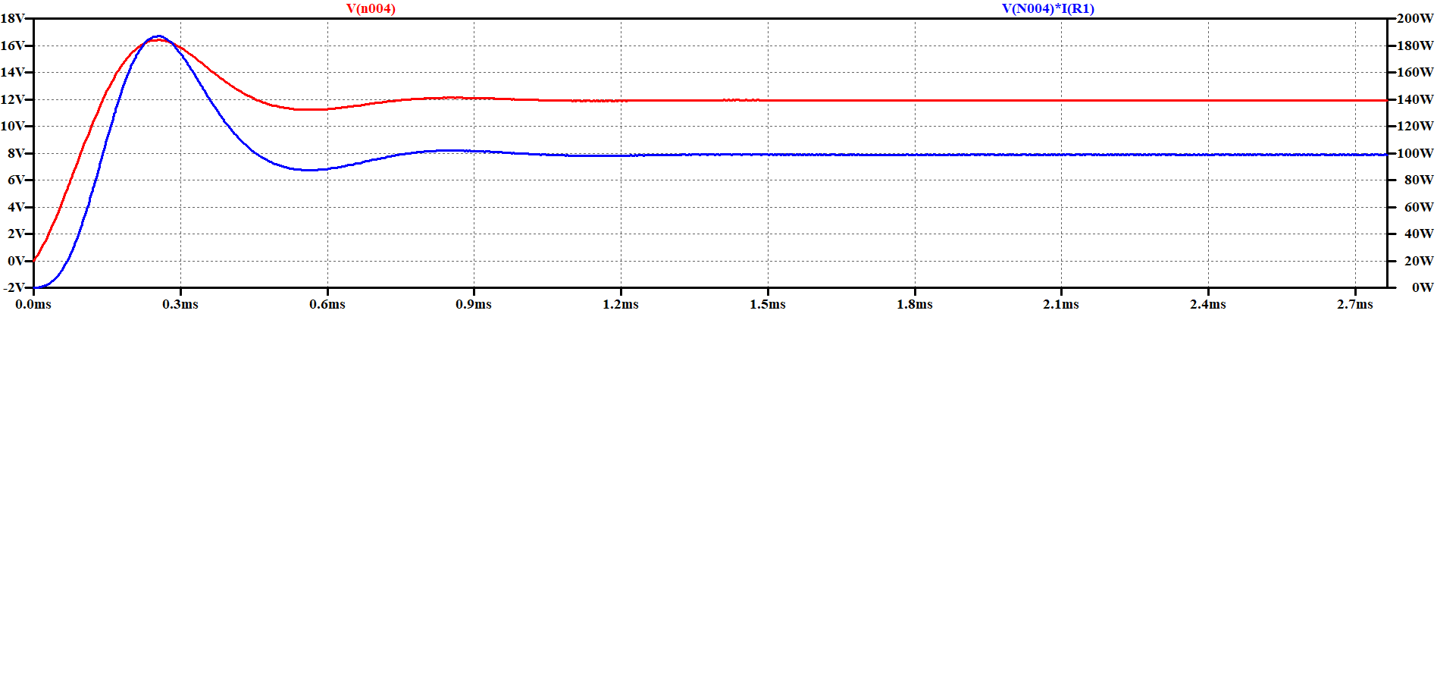
Mustafa/Open Loop Design/Simulation Results/Output Voltage and Power waveforms when Vin is 220V.png
