mustafayildz/EE464-Term-Project-/Mustafa/Open Loop Design/Simulation Results/Output Voltage and Power waveforms when Vin is 400V.png

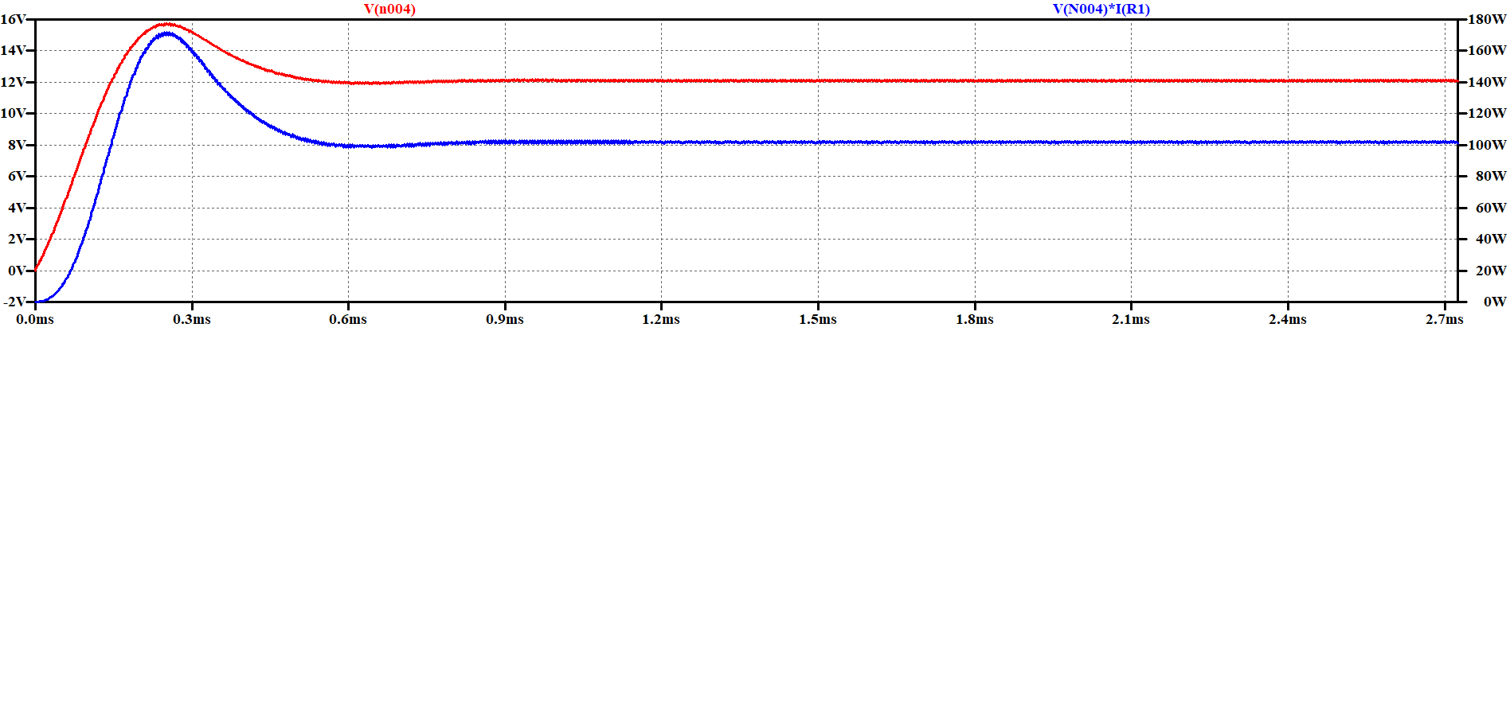
Mustafa/Open Loop Design/Simulation Results/Output Voltage and Power waveforms when Vin is 400V.png
