mustafayildz/EE464-Term-Project-/Simulation Results/220Vin_Output Voltage.png

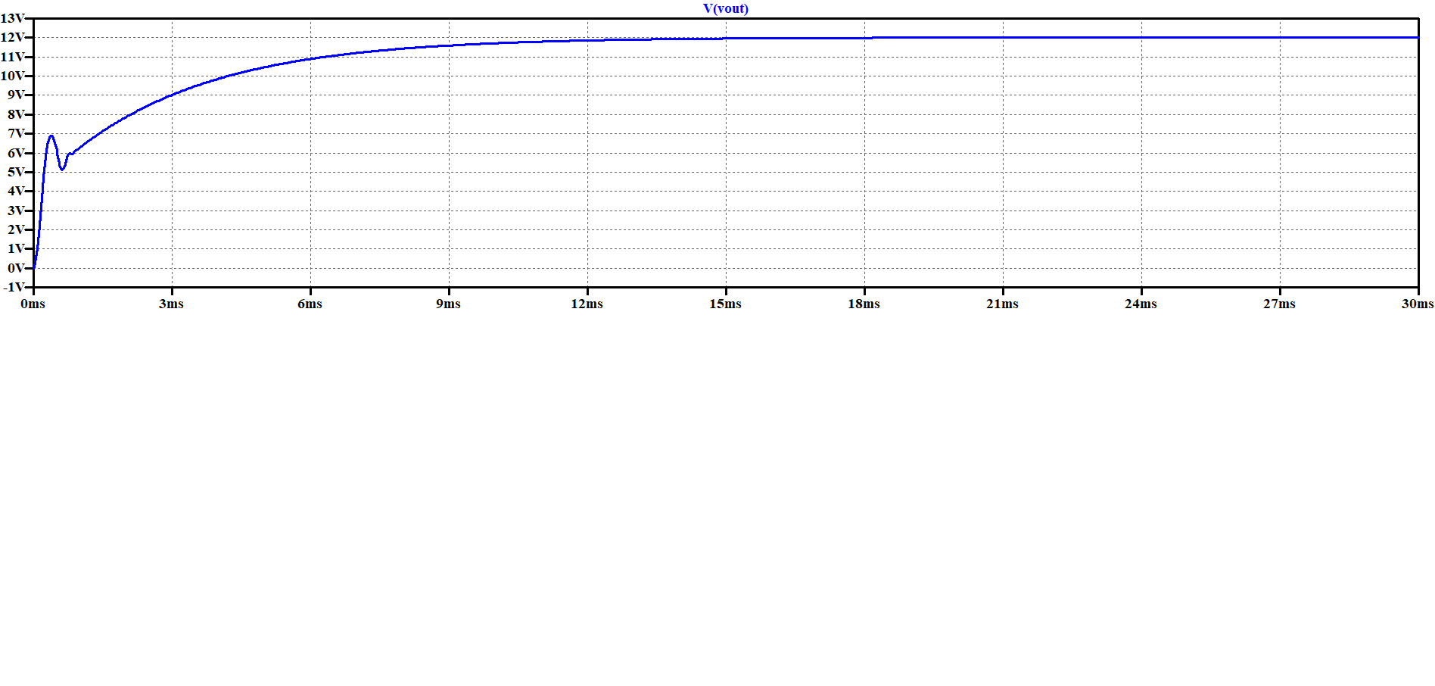
Simulation Results/220Vin_Output Voltage.png
