mustafayildz/EE464-Term-Project-/PCB Output Documentation/SchematicFile.pdf

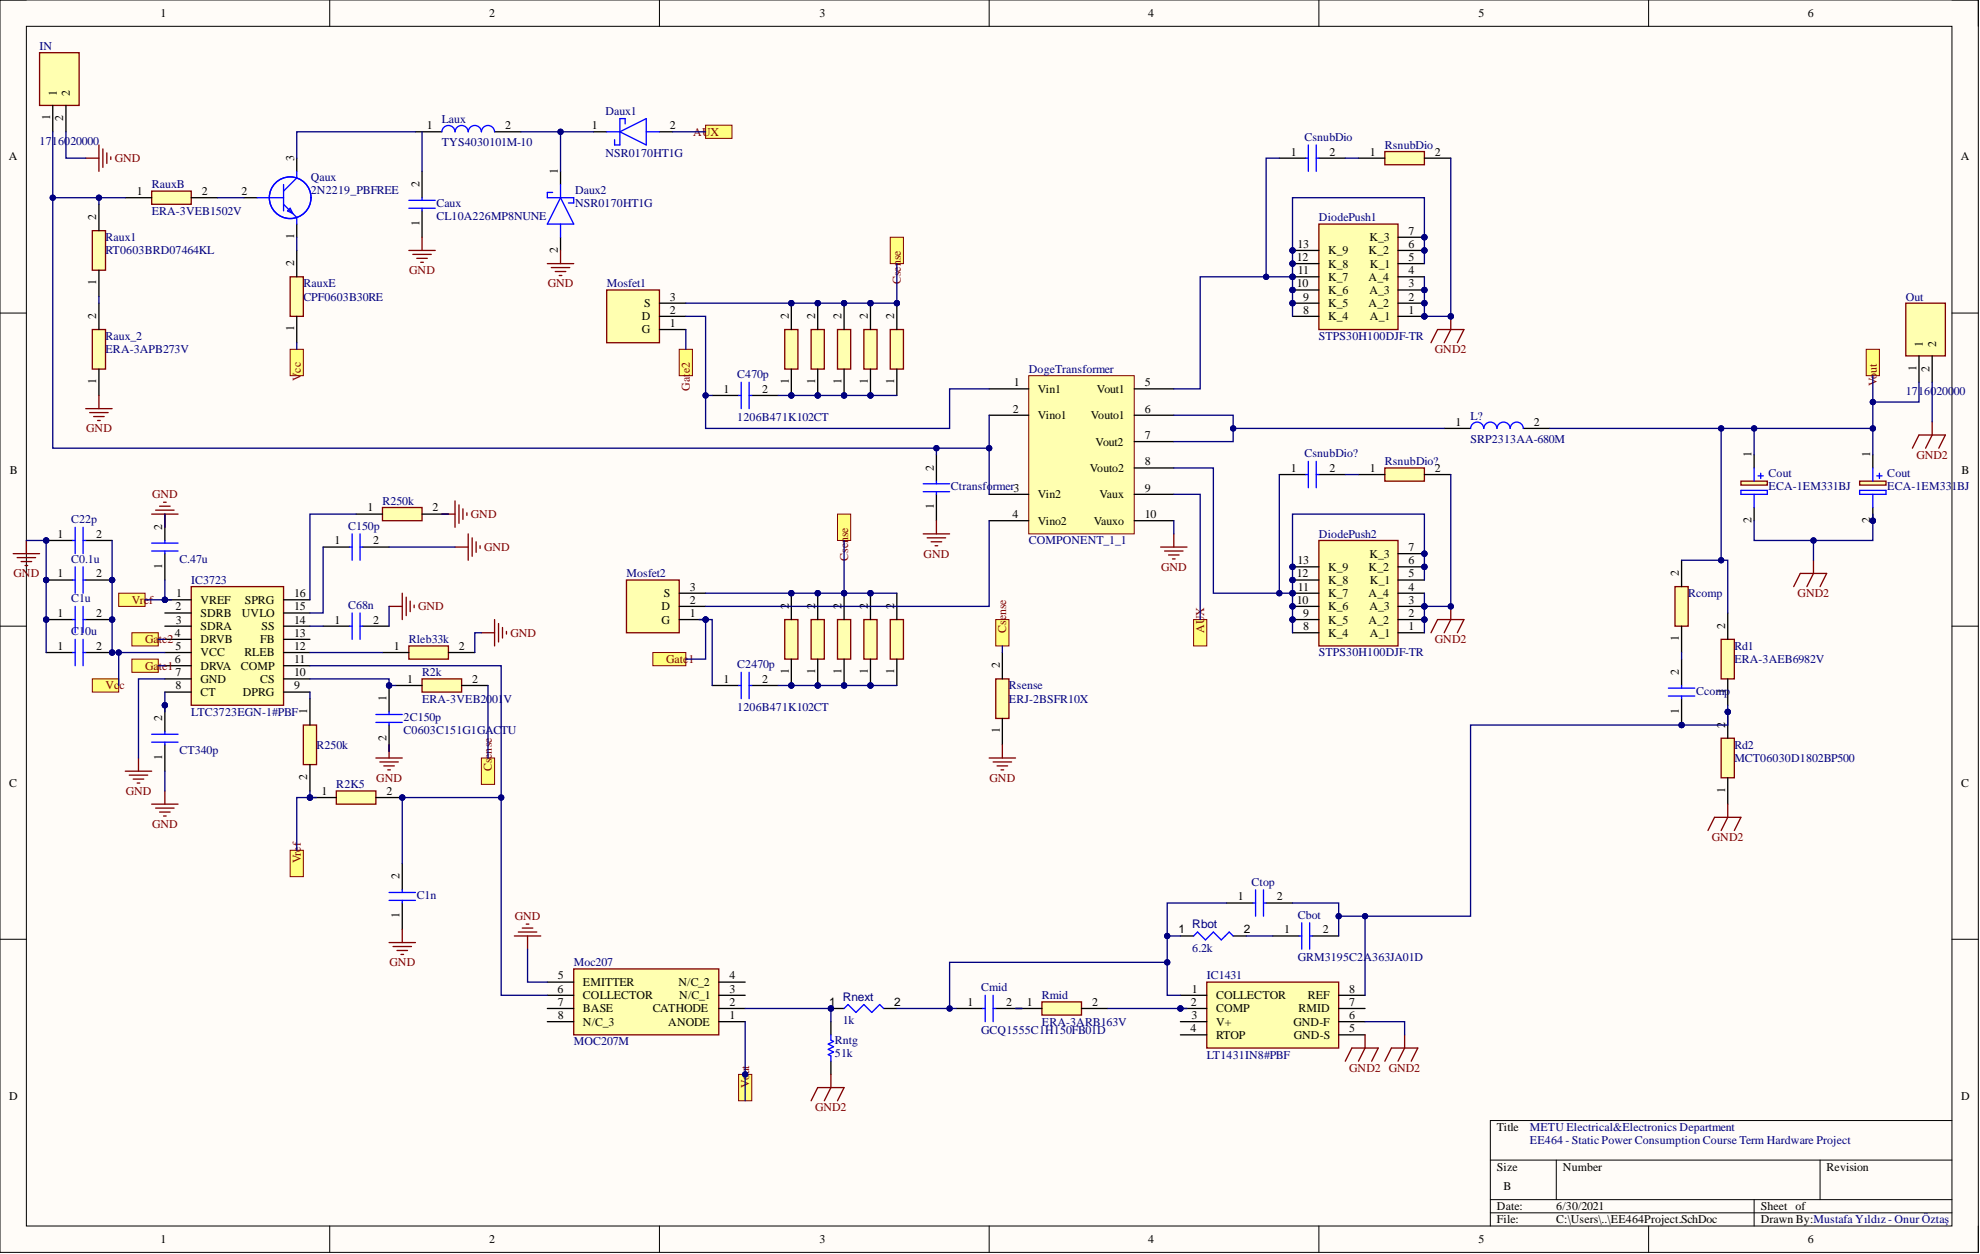
[picture p133: page 1]

Title
EE464 - Static Power Consumption Course Term Hardware Project

METU Electrical&Electronics Department

Mustafa Yıldız - Onur Öztaş
