mustafayildz/EE464-Term-Project-/PCB Output Documentation/PCB_Project_1.pdf

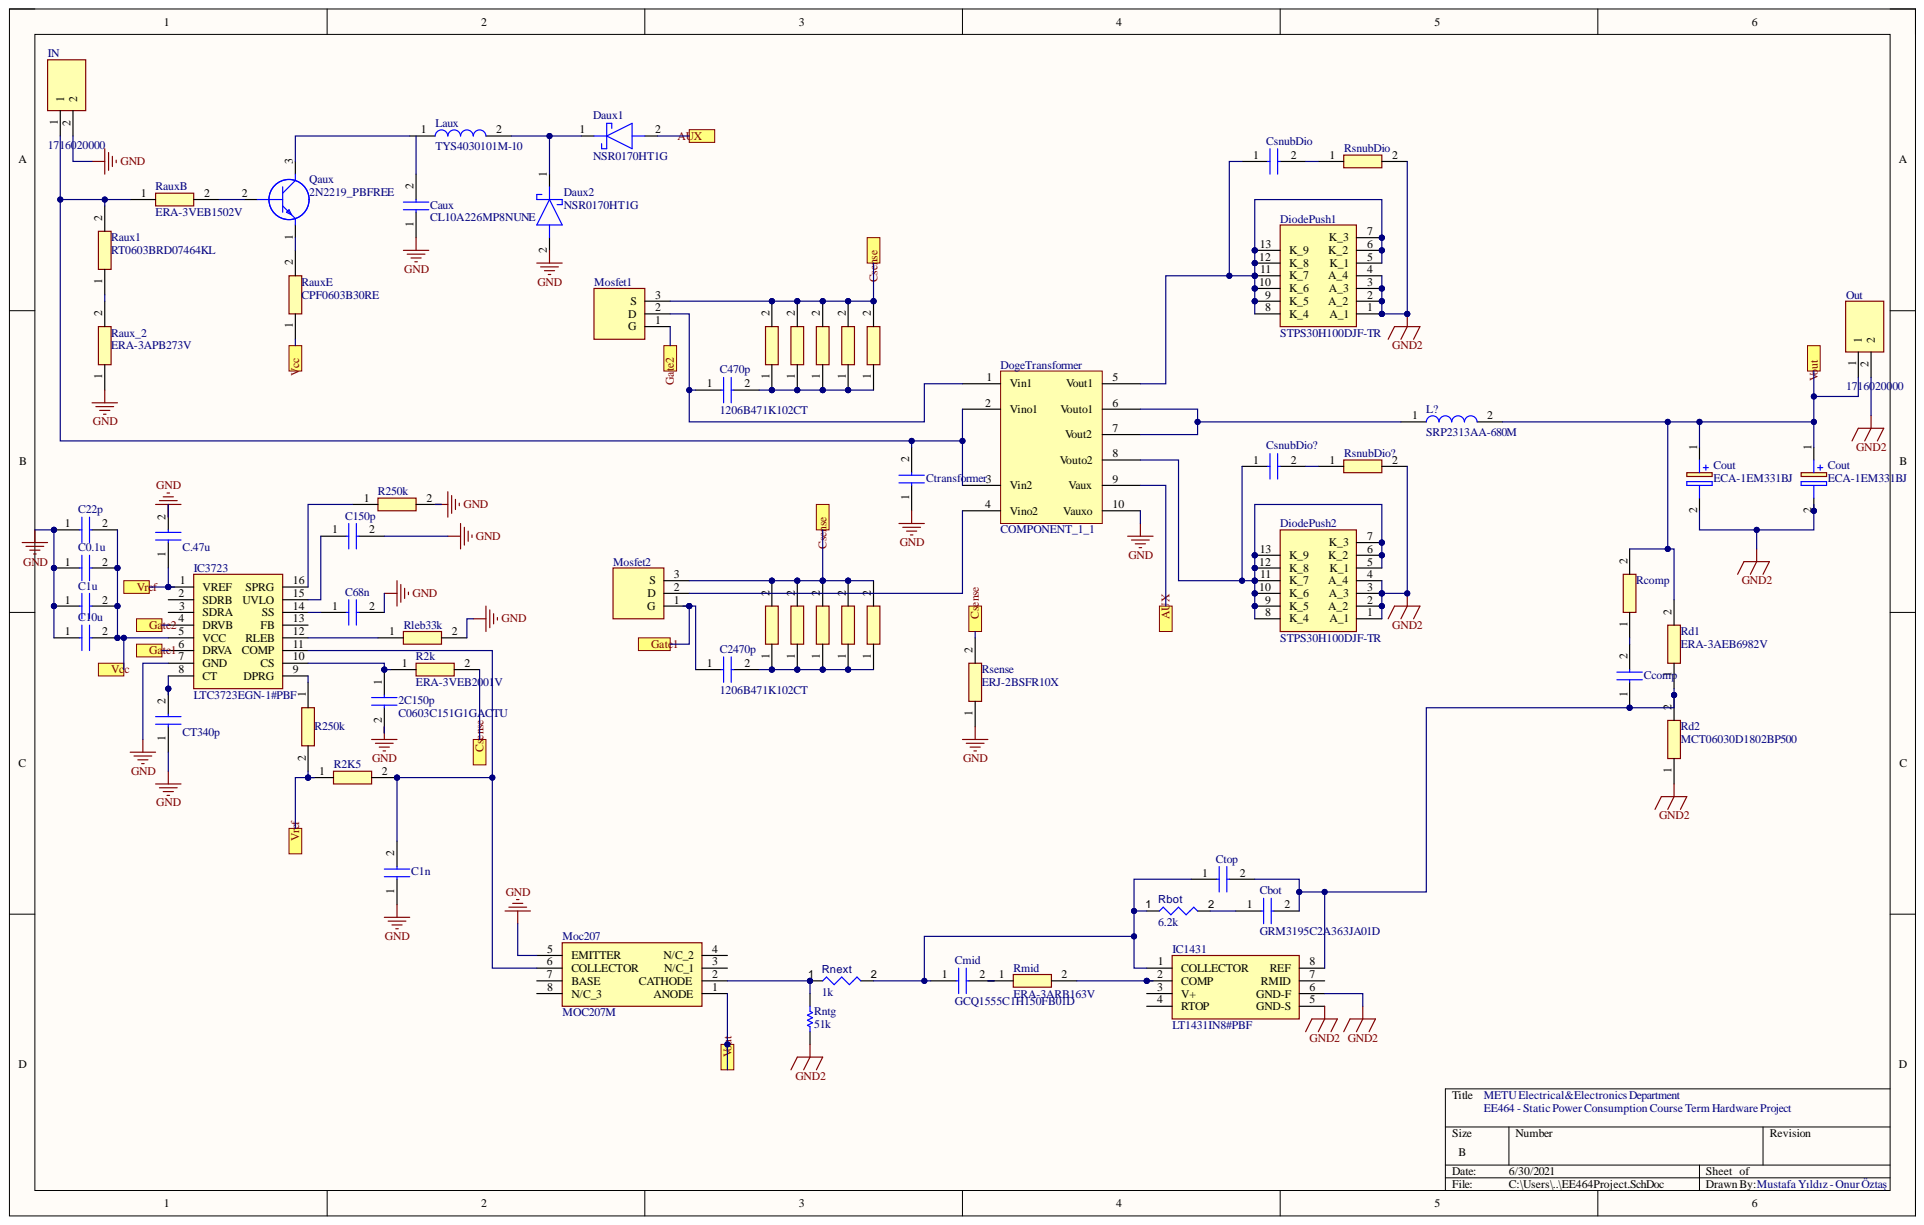
[picture p134: page 1]

Vref | SDRB 2

Title
EE464 - Static PowerConsumption Course Term Hardware Project

Size B | Number | Revision

Date: 6/30/2021 | Sheet of
File: C:\Users\..\EE464Project.SchDoc | Drawn By: Mustafa Yıldız - Onur Öztaş

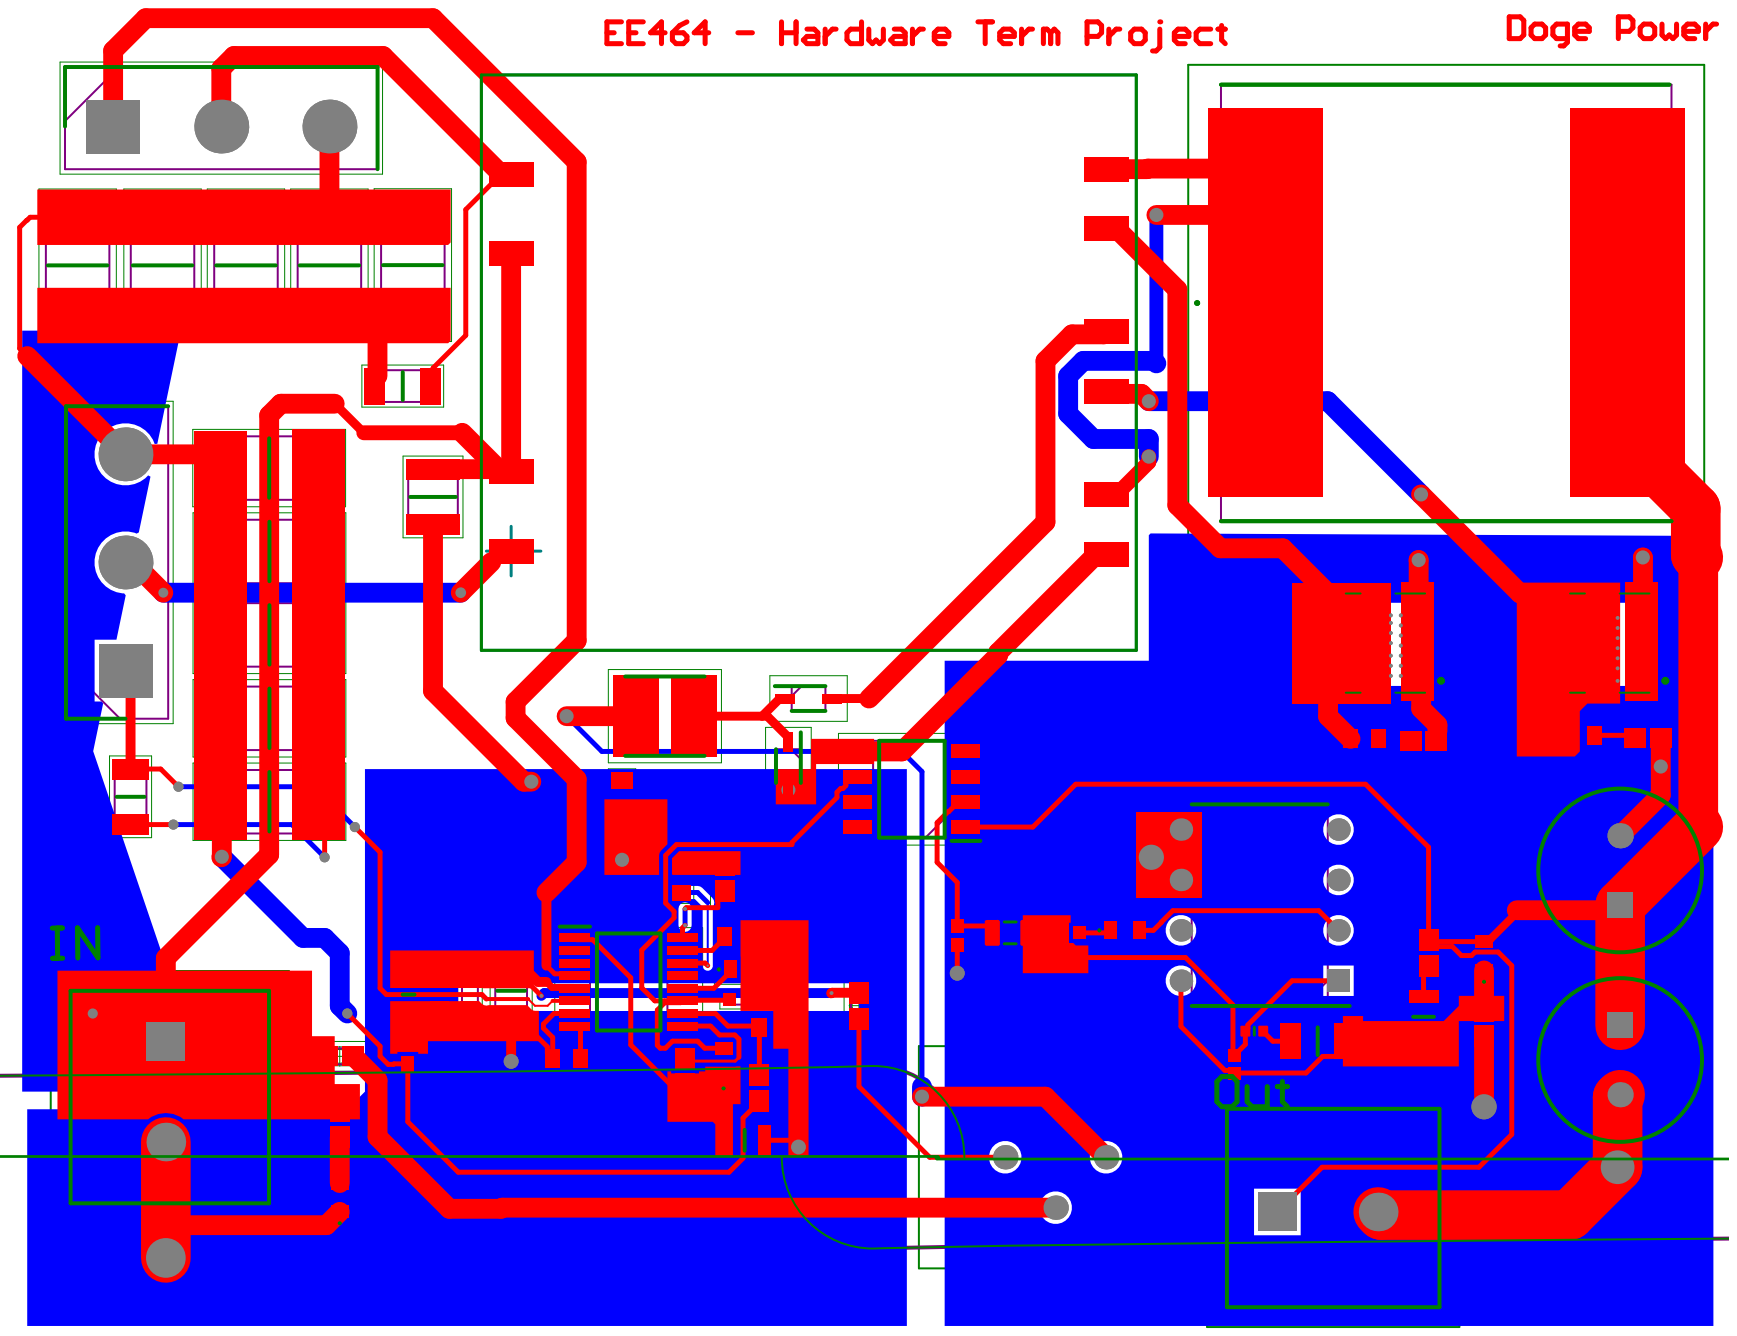
[picture p135: page 2]
