mustafayildz/EE464-Term-Project-/FinalSnubberDesignUpdated.asc

C1: polcap; 330µ; V=100 Irms=720m Rser=56m Lser=0
C2: cap; 2.2n
C3: cap; 120p
C4: cap; 36.7n
C5: cap; 15p
C6: cap; 150p
C7: cap; 0.34n
C8: cap; 0.47µ
C9: cap; 68n
C10: cap; 1n
C11: cap; 0.1µ
C12: cap; 200p
C13: cap; 200p
C14: cap; 500p
C16: cap; 500p
C17: polcap; 330µ; V=100 Irms=720m Rser=56m Lser=0
D1: schottky; RBR3M60A
D2: schottky; RBR3M60A
L1: ind2; 2.08m
L2: ind2; 2.08m
L3: ind2; 8.14µ
L4: ind2; 8.14µ
L5: ind; 160µ; Rser=40m
L6: ind; 5.2m
L7: ind; 5.2m
M1: nmos; STN3N45K3
M2: nmos; STN3N45K3
R1: res; 1.44
R2: res; 50k
R3: res; 70.5k
R4: res; 18.55k
R5: res; 3.36k
R6: res; 5.9k
R7: res; 16k
R8: res; 100m
R9: res; 2.5k
R10: res; 10
R11: res; 2k
R12: res; 250k
R13: res; 250k
R14: res; 33k
R15: res; 10
R16: res; 10
R17: res; 1k
R18: res; 170
R19: res; 22
R20: res; 22
R21: res; 225
R22: res; 225
R23: res; 225
R24: res; 225
R25: res; 225
R26: res; 225
R28: res; 225
R29: res; 225
R30: res; 225
R31: res; 225
U1: LTC3723-1
U2: MOC207
U3: LT1431
V3: voltage; 400
Named nets: 0, Vout, G1, G2, REF, Vin, Vsupply, CS, COMP
K1 L1 L2 L3 L4 0.9995
.tran 0 40m 0
