mustafayildz/EE464-Term-Project-/Mustafa/Closed Loop Design/Push_Pull_100W.asc

C1: polcap; 330µ; V=100 Irms=720m Rser=56m Lser=0
C2: cap; 2.2n
C3: cap; 120p
C4: cap; 36.7n
C5: cap; 15p
C6: cap; 150p
C7: cap; 0.32n
C8: cap; 0.47µ
C9: cap; 68n
C10: cap; 1n
D1: schottky; RBR3M60A
D2: schottky; RBR3M60A
L1: ind2; 3.6m
L2: ind2; 3.6m
L3: ind2; 14.06µ
L4: ind2; 14.06µ
L5: ind; 80µ; Rser=40m
M1: nmos; IPI600N25N3
M2: nmos; IPI600N25N3
R1: res; 1.44
R2: res; 50k
R3: res; 70.5k
R4: res; 18.55k
R5: res; 3.36k
R6: res; 5.9k
R7: res; 16k
R8: res; 250m
R9: res; 2.5k
R10: res; 10
R11: res; 2k
R12: res; 250k
R13: res; 250k
R14: res; 33k
R15: res; 10
R17: res; 1k
U1: LTC3723-1
U2: MOC207
U3: LT1431
V3: voltage; 220
V4: voltage; 12
Named nets: 0, Vcc, Vout
K1 L1 L2 L3 L4 1
.tran 0 40m 0
