mustafayildz/EE464-Term-Project-/Mustafa/Open Loop Design/Open_loop_trial_for_220Vin.asc

C1: polcap; 330µ; V=100 Irms=720m Rser=0.09 Lser=0 mfg="Nichicon" pn="UPR2A331MRH" type="Al electrolytic"
D1: schottky; PDS5100
D2: schottky; PDS5100
L1: ind2; 3.6m
L2: ind2; 3.6m
L3: ind2; 14.06µ
L4: ind2; 14.06µ
L5: ind; 22µ
M1: nmos; BSC060N10NS3
M2: nmos; BSC060N10NS3
R1: res; 2.61
V1: voltage; PULSE(0 12 5u 10n 10n 4.1u 10u)
V2: voltage; PULSE(0 12 0 10n 10n 4.1u 10u)
V3: voltage; 220
Named nets: 0, G1, G2
K1 L1 L2 L3 L4 1
.tran 0 15m 0
