mustafayildz/EE464-Term-Project-/Mustafa/Open Loop Design/Simulation Files/Output Filter AC Analysis.asc

C1: polcap; 330µ; V=100 Irms=720m Rser=0.09 Lser=0 mfg="Nichicon" pn="UPR2A331MRH" type="Al electrolytic"
L5: ind; 22µ
V1: voltage; SINE(0 5 100k); AC 10
Named nets: 0
.ac dec 10 1 150k
