mustafayildz/EE464-Term-Project-/Onur/Analytical_Calculated_Circuit.asc

C1: polcap; 63n; V=100 Irms=720m Lser=0
D1: diode
D2: diode
L1: ind2; 2.08m
L2: ind2; 2.08m
L3: ind2; 8.14µ
L4: ind2; 8.14µ
L5: ind; 160µ
R1: res; 1.44
S1: sw; MYSW
S2: sw; MYSW
V1: voltage; 400
V2: voltage; PULSE(0 1 0 0 0 0.0000024 0.00001)
V3: voltage; PULSE(0 1 0.000005 0 0 0.0000024 0.00001)
Named nets: 0, Vin, G1, G2, Vout, V_D, V_switch
.tran 0 20m 0
.model MYSW SW(Ron=0.001 Roff=1000Meg Vt=0.5 Vh=0)
K1 L1 L2 L3 L4 1
