mustafayildz/EE464-Term-Project-/Onur/Thermal_Circuit_Diode.asc

Loss1: current; 4.67
R_CS1: res; 31
R_JC1: res; 2
Named nets: 0, T_ambient, T_junc
