mustafayildz/EE464-Term-Project-/Onur/Thermal_Circuit.asc

Loss: current; 6.716
R_CS: res; 0.35
R_JC: res; 2.5
R_SA: res; 8
Named nets: 0, T_ambient, T_junc
.tran 0 40m 0
