mustafayildz/EE464-Term-Project-/(list of files, drawings)

Other design files:
PCB_Project_1/EE464Project.PcbDoc
PCB_Project_1/EE464Project.SchDoc
PCB_Project_1/PCB_Project_1.PrjPcb
PCB_Project_1/ProjectPCBLib.PcbLib
PCB_Project_1/Schlib1_Inductor.SchLib
PCB_Project_1/Schlib1_Transformer.SchLib
PCB_Project_1/SchLib.SchLib
