mustafayildz/EE464-Term-Project-/(commit log)

2021-04-17 Open loop design
    Open loop design for 220V input is added for trial.
2021-04-18 Simulation files and results
    Open loop design simulation files and their results are added. Also, the AC analysis for the designed output filter is included.
2021-04-26 Analytical calculations and parameter generator excel.
    [Analytical_Calculation_Generator.xlsx]
2021-04-30 Capacitors added
    [BOM.xlsx]
2021-05-01 Same Document only Changed Values
    [Analytical_Calculation_Generator.xlsx]
2021-05-01 Magnetic Design and Loss Calculations are added
2021-05-01 BOM Table
    [BOM.xlsx]
2021-05-01 Case and Heatsink
2021-05-01 All components added
    [BOM.xlsx]
2021-05-01 Magnetic Design and Thermal Circuit added
2021-05-07 Diode Thermal Circuit
2021-05-07 Font editting
    [Analytical_Calculation_Generator.xlsx]
2021-06-15 Transformer for PCB
    [transformator.stp]
2021-06-16 PCB schematic are added
    [Component List.xlsx, EE464Project.PcbDoc, EE464Project.SchDoc, PCB_Project_1.PrjPcb, ProjectPCBLib.PcbLib, SchLib.SchLib]
2021-06-22 3D models and footprints of magnetic components.
2021-06-23 3D model of the inductor
    [inductor.stp]
2021-06-23 Magnetic materials are added to schematic
2021-06-24 new pcb
    [EE464Project.PcbDoc, EE464Project.SchDoc, PCB_Project_1.PrjPcb, ProjectPCBLib.PcbLib, SchLib.SchLib]
2021-06-28 Transformer and Indcutor schematics added
2021-06-28 Pin Updates
2021-06-29 PCB layout placement is completed. Routing is left only.
2021-06-30 PCB drawing, routing etc. are all completed.
    Whole PCB documents are uploaded. Also, 3D step model is also uploaded for box design.
2021-06-30 PCB Output Documentation Files are Uploaded
    3D representation of a model in a PDF document, the schematics file and the smart pdf output of the Altium Program are uploaded for the PCB design
    [Component List.xlsx, EE464Project.PcbDoc, EE464Project.SchDoc, PCB_Project_1.PrjPcb, ProjectPCBLib.PcbLib, SchLib.SchLib]
2021-07-01 Cost analysis and PCB part of the final report is included.
2021-07-02 Simulation Results are obtained for both input cases
    [PCB_Project_1.xlsx]
